gigaj0ule/safebridge/README.md

# safebridge

current limited h bridge

contains 3 modules

half bride module (2x)

electronic fuse (1x)
