gigaj0ule/safebridge/rmp_efuse_2/Schematic (PDF)/EFUSE 2.0.0.pdf

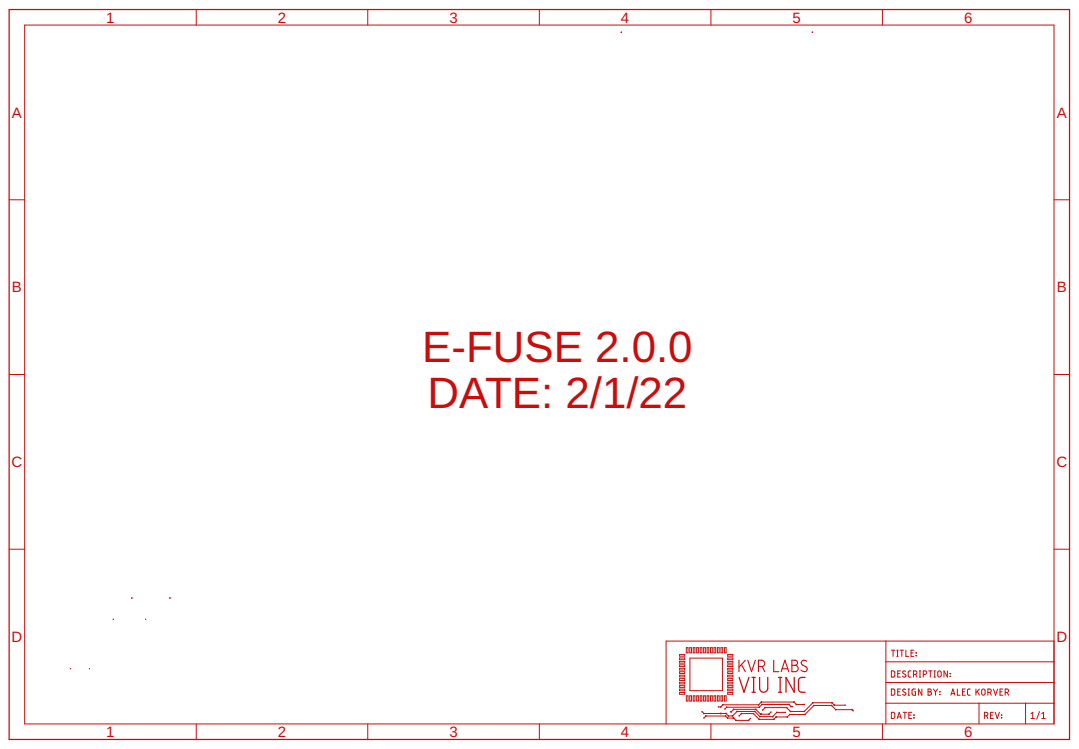
[picture p1: page 1]

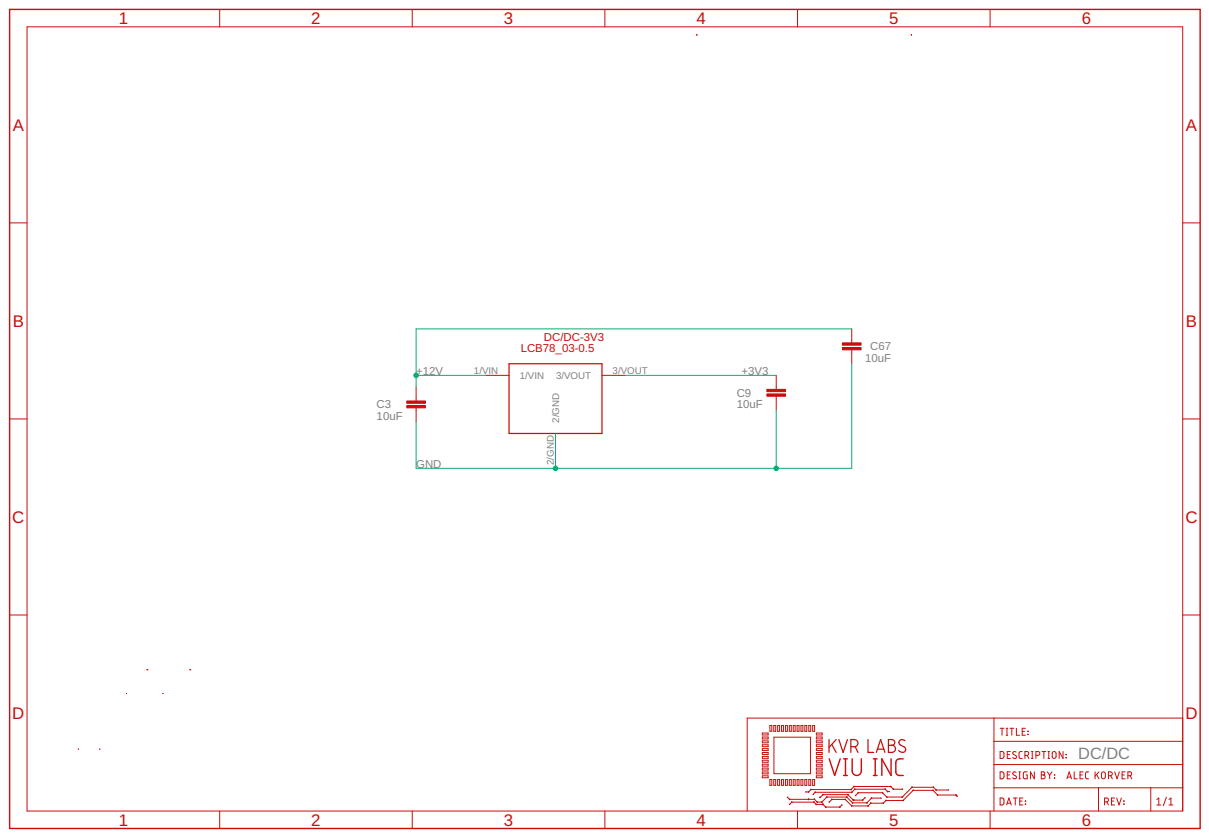
[picture p2: page 2]

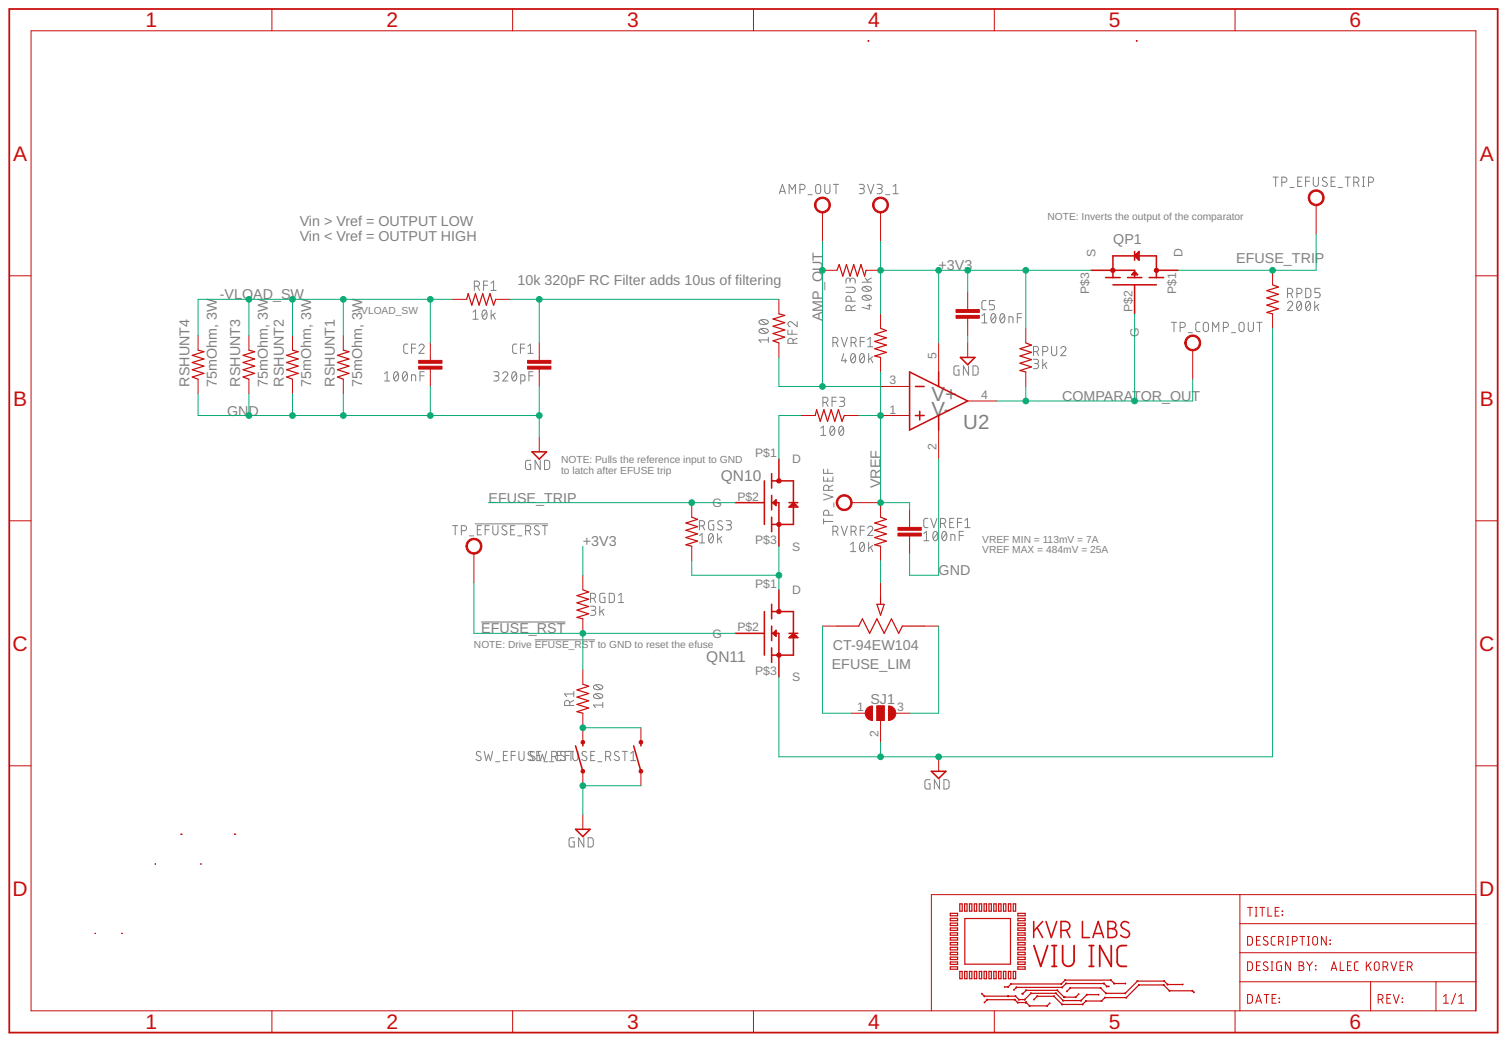
[picture p3: page 3]

Vin > Vref = OUTPUT LOW
Vin < Vref = OUTPUT HIGH

NOTE: Inverts the output of the comparator

10k 320pF RC Filter adds 10us of filtering

NOTE: Pulls the reference input to GND
to latch after EFUSE trip

EFUSE_RST
NOTE: Drive EFUSE_RST to GND to reset the efuse

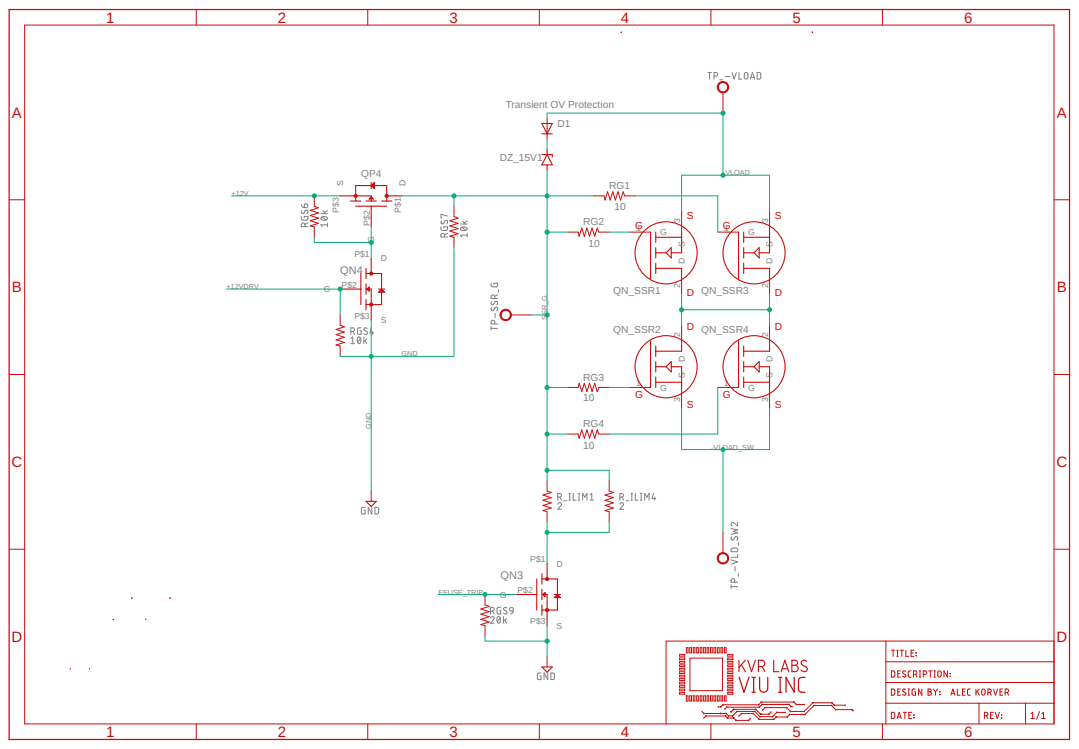
[picture p4: page 4]
