gigaj0ule/safebridge/rmp_fbps_mobo_1/Schematic (PDF)/RMP - FBPS MOBO 0.0.1.pdf

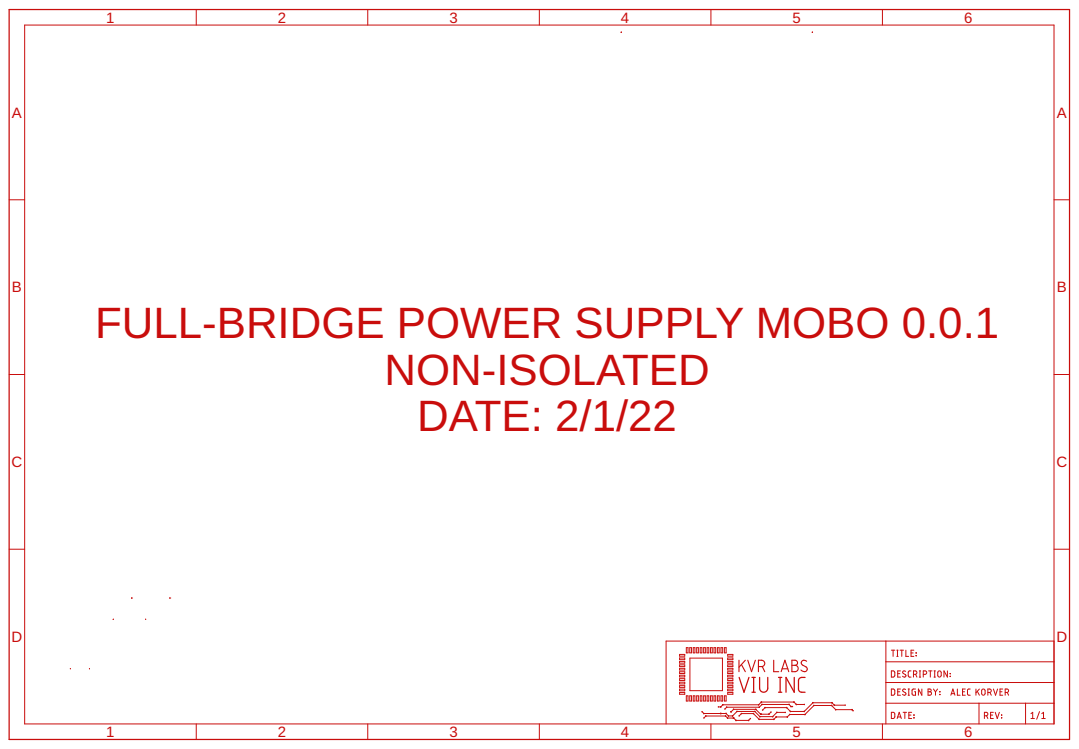
[picture p5: page 1]

FULL-BRIDGE POWER SUPPLY MOBO 0.0.1

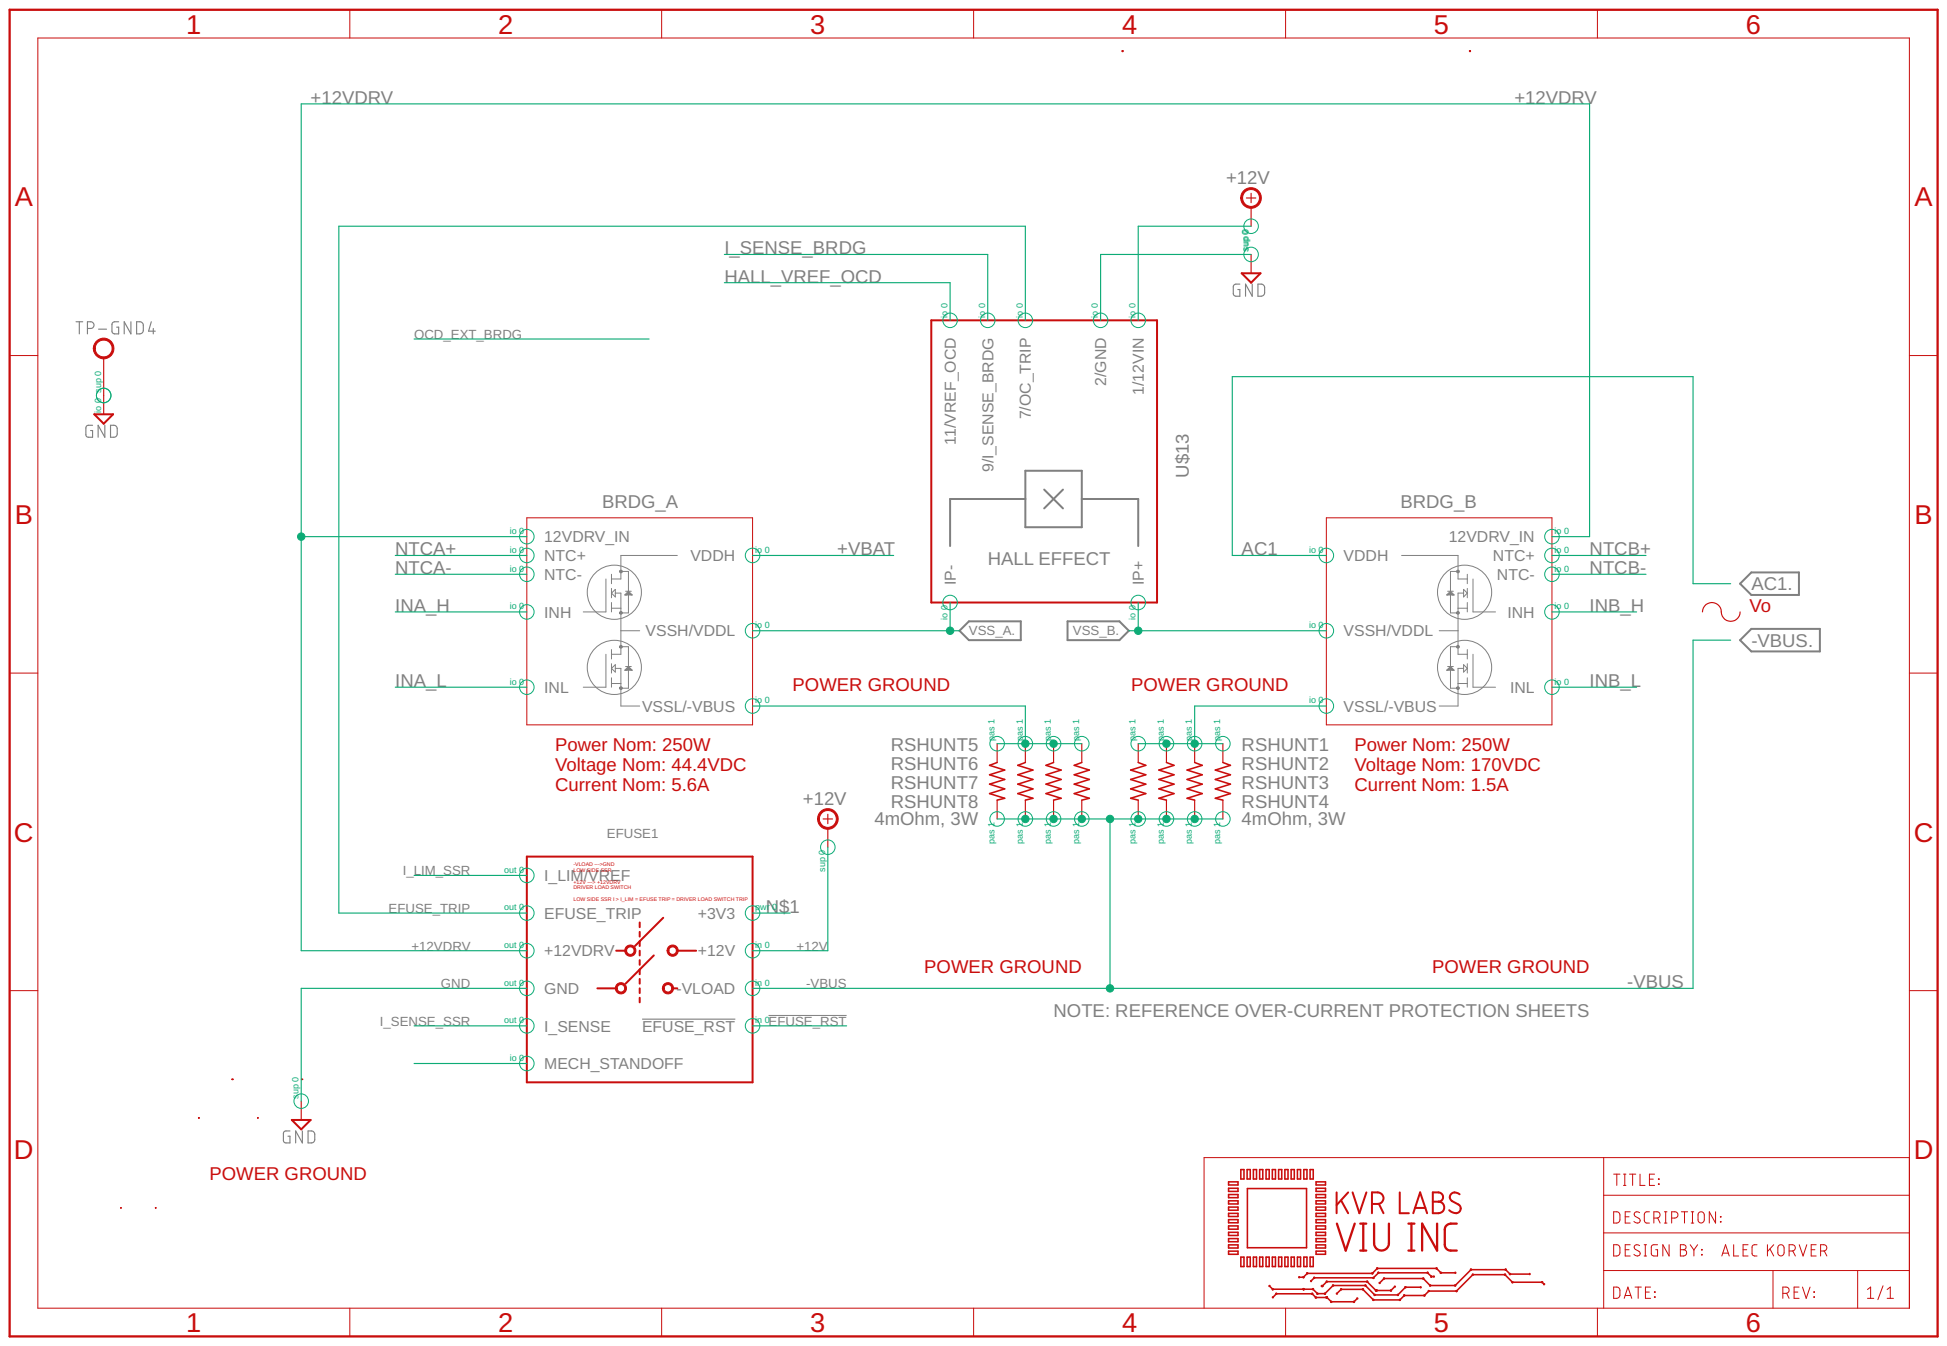
[picture p6: page 2]

LOW SIDE SSR I > I_LIM = EFUSE TRIP = DRIVER LOAD SWITCH TRIP

NOTE: REFERENCE OVER-CURRENT PROTECTION SHEETS

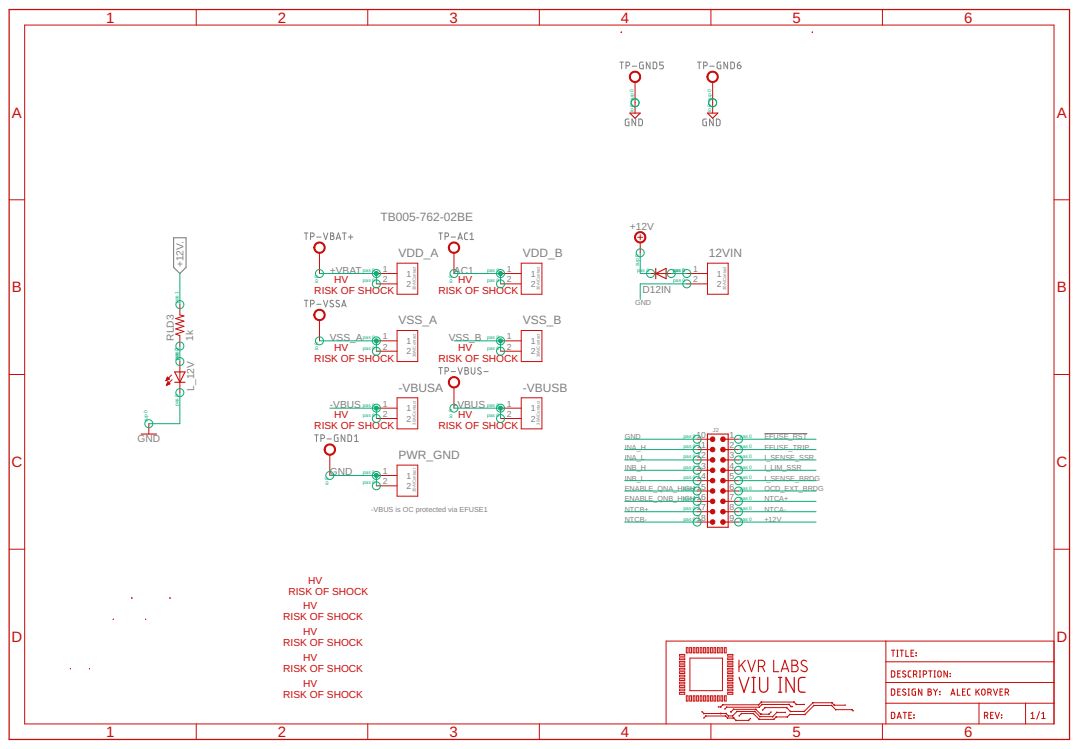
[picture p7: page 3]

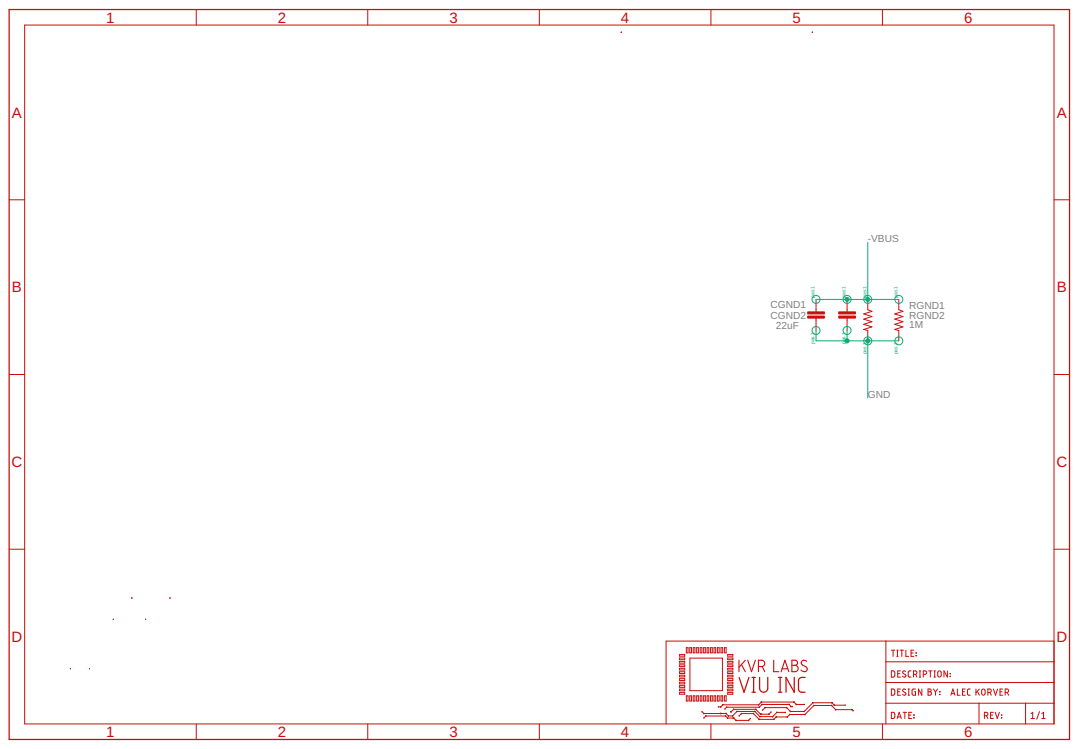
[picture p8: page 4]
