gigaj0ule/safebridge/rmp_half_bridge_1/Schematic (PDF)/RMP - HALF BRIDGE 0.0.1.pdf

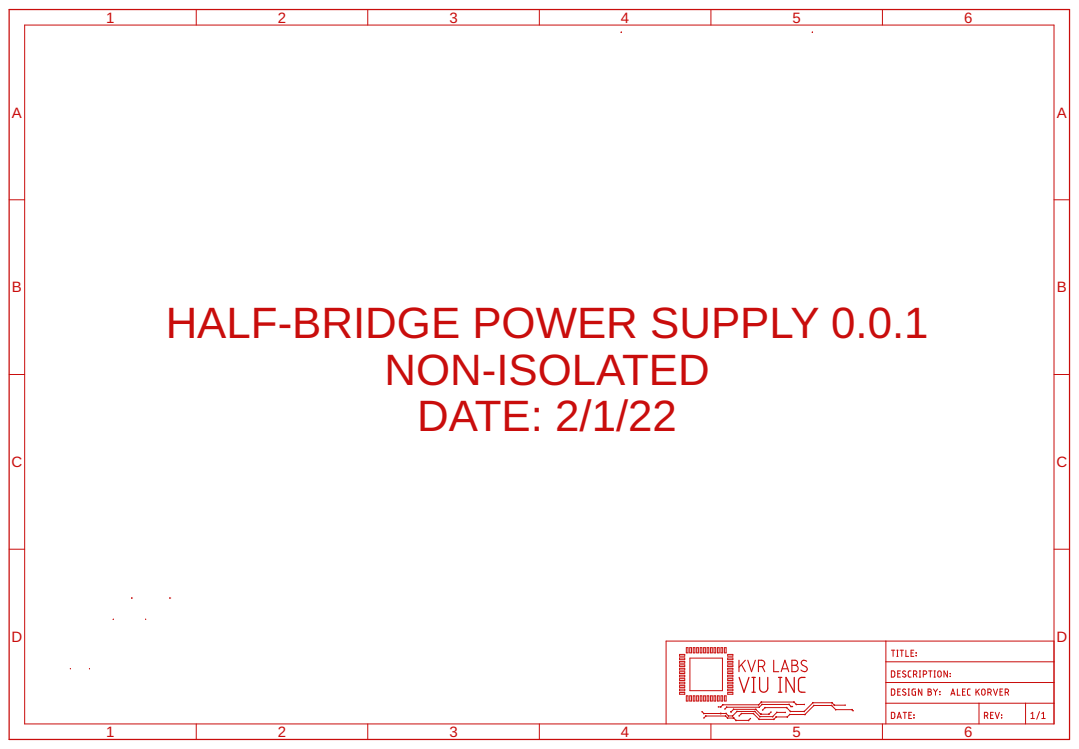
[picture p9: page 1]

HALF-BRIDGE POWER SUPPLY 0.0.1

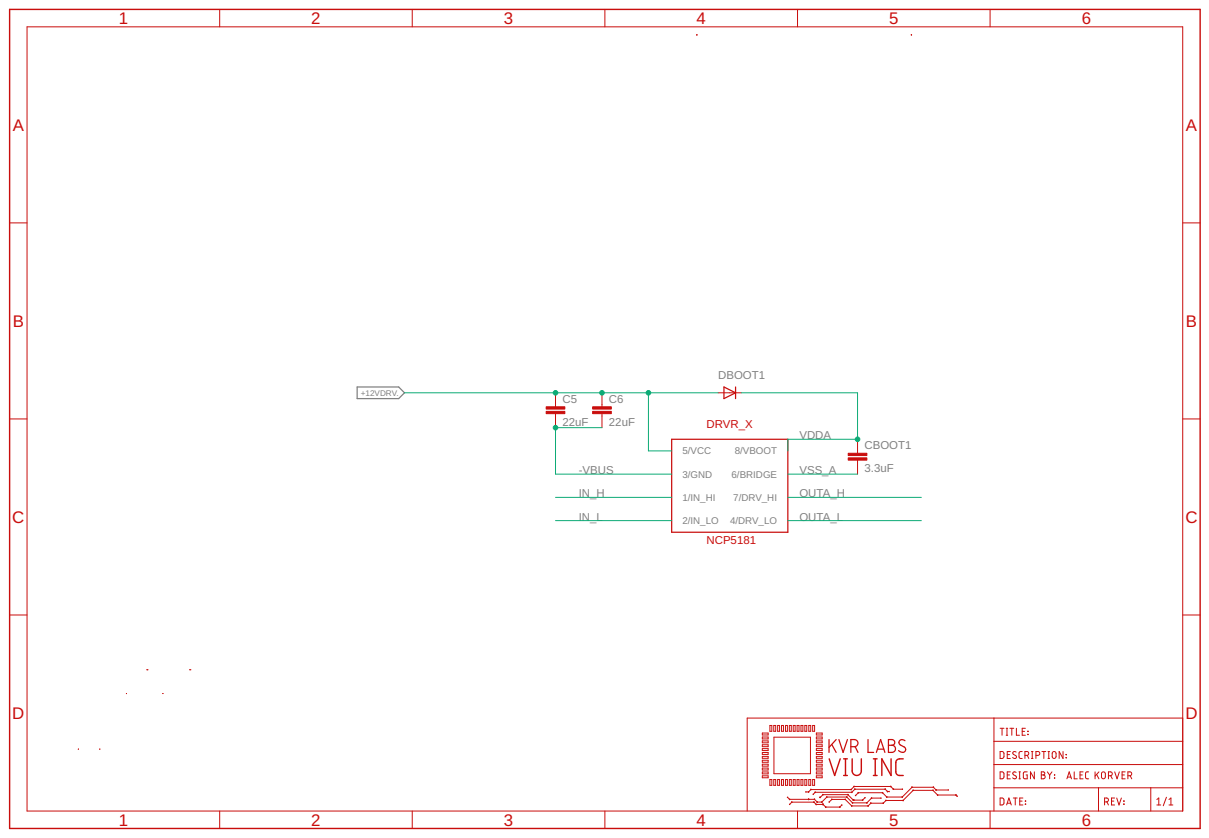
[picture p10: page 2]

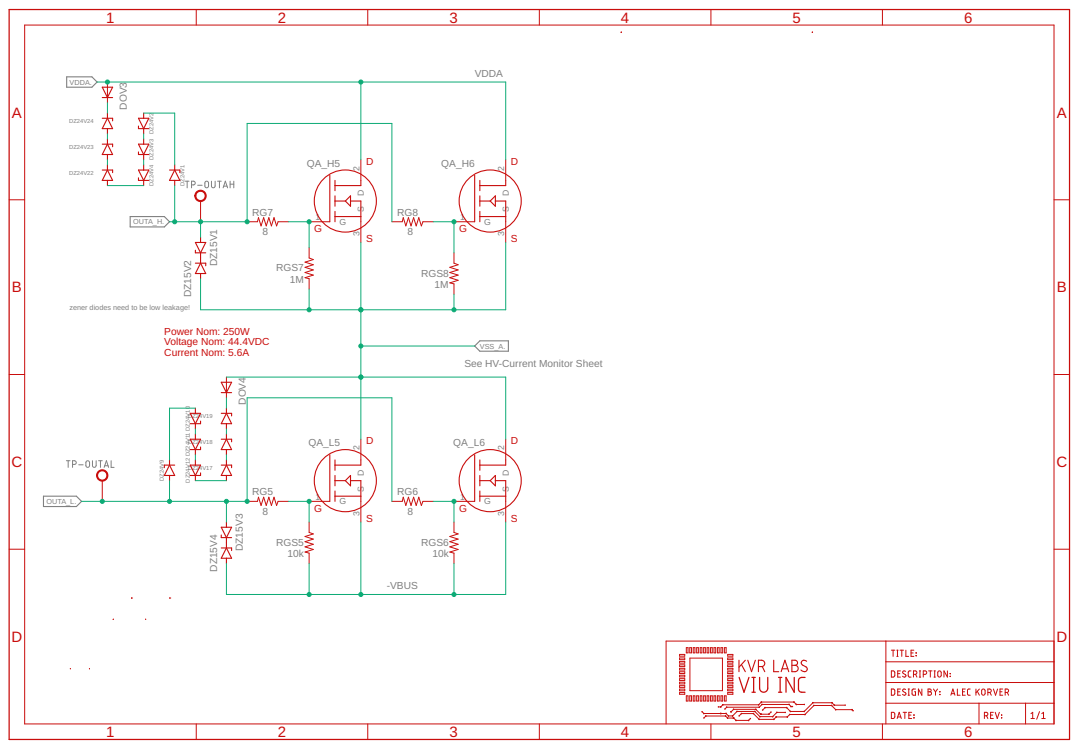
[picture p11: page 3]

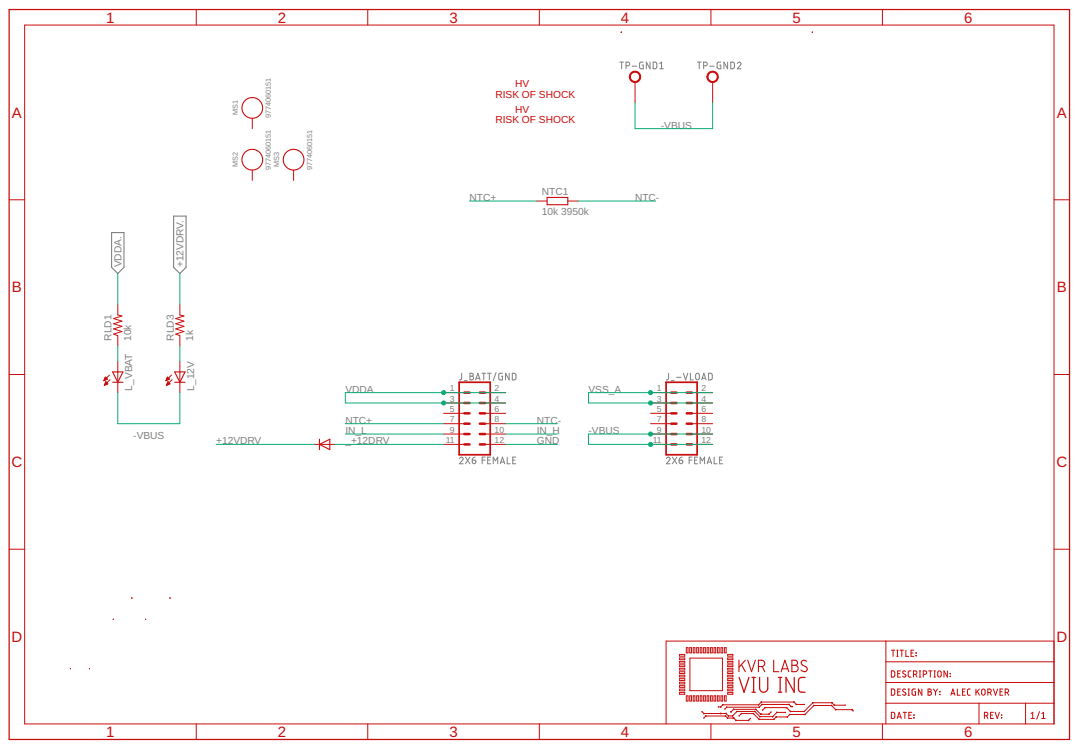
[picture p12: page 4]

10k 1k 10k 3950k RLD1 RLD3 L_VBAT L_12V 108642 9753111 12 108642 9753111 12 NTC1 MS1 9774060151 MS2 9774060151 MS3 9774060151 VDDA. VDDA VSS_A -VBUS -VBUS -VBUS GND IN_L IN_H _+12DRV +12VDRV. +12VDRV NTC+ NTC+ NTC- NTC- ABCD 1 2 3 4 5 6 ABCD 1 2 3 4 5 6 HV RISK OF SHOCK HV RISK OF SHOCK
