gigaj0ule/safebridge/rmp_fbps_mobo_1/Eagle/RMP - FBPS MOBO 0.0.1.brd

## EAGLE design rmp_fbps_mobo_1/Eagle/RMP - FBPS MOBO 0.0.1.brd (2022-04-21)

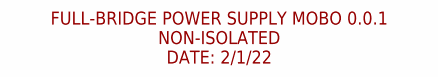
[picture p13: schematic RMP - FBPS MOBO 0.0.1.sch, sheet 1]

Notes on the sheet:
FULL-BRIDGE POWER SUPPLY MOBO 0.0.1 NON-ISOLATED DATE: 2/1/22

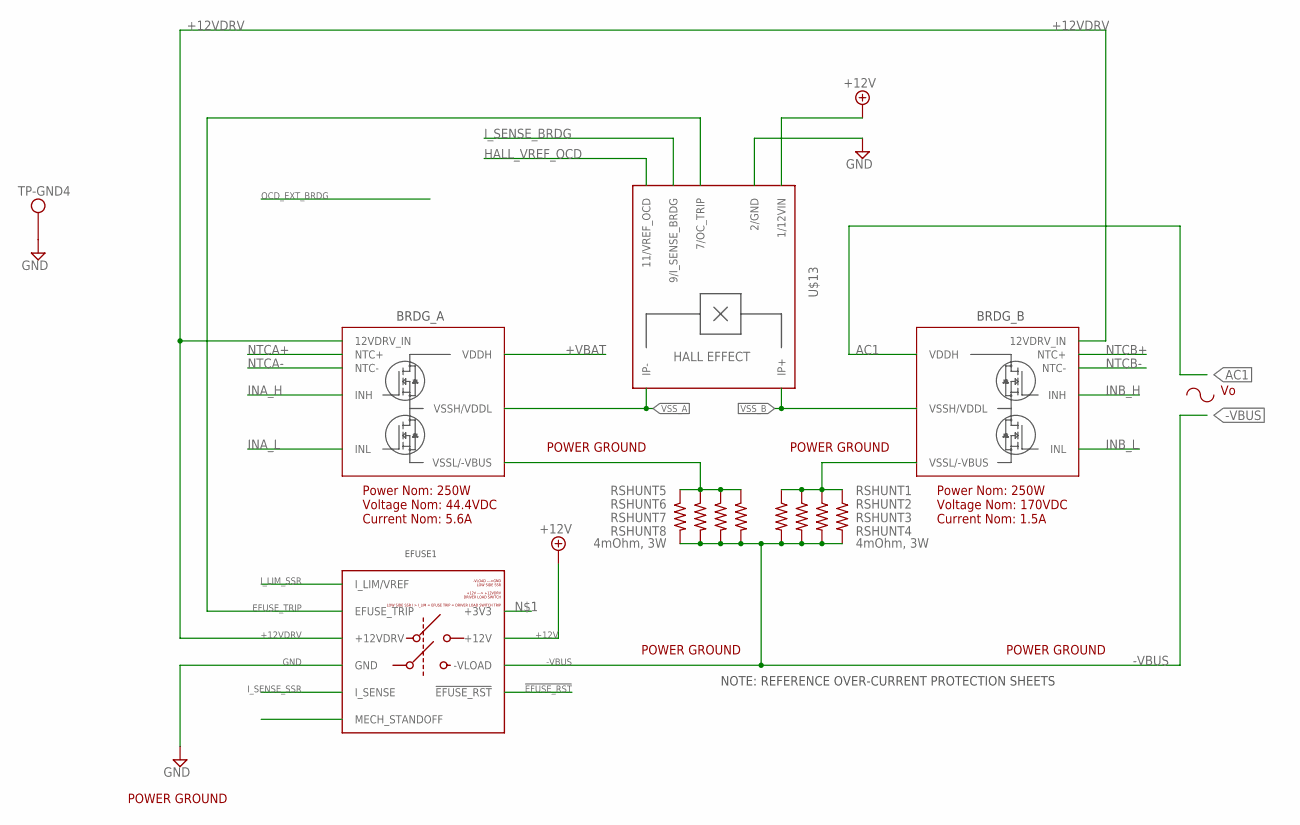
[picture p14: schematic RMP - FBPS MOBO 0.0.1.sch, sheet 2, H BRIDGE - AC/DC STAGE]

Parts:
BRDG_A: 1/2BRIDGE; LCSC_PART DNP/CUSTOM
BRDG_B: 1/2BRIDGE; LCSC_PART DNP/CUSTOM
EFUSE1: EFUSE_2.0.0; LCSC_PART DNP/CUSTOM
RSHUNT1, RSHUNT2, RSHUNT3, RSHUNT4, RSHUNT5, RSHUNT6, RSHUNT7, RSHUNT8: 4mOhm, 3W; R2512; LCSC_PART C728322
TP-GND4: THM_TESTPOINT_5000_SERIES; THM-TESTPOINT; LCSC_PART DNP
U$13: HALL_EFFECT_CURRENT_MONITOR; HALL_CURRENT_MONITOR; LCSC_PART DNP/CUSTOM

Connections:
!EFUSE_RST: EFUSE1.12/!EFUSE_RST (!EFUSE_RST); also elsewhere on the board
+12V: EFUSE1.11/12VIN (+12V), U$13.1/+12VIN (1/12VIN); also elsewhere on the board
+12VDRV: BRDG_A.11/+12DRVR (12VDRV_IN), BRDG_B.11/+12DRVR (12VDRV_IN), EFUSE1.12/12VDRV (+12VDRV)
+VBAT: BRDG_A.1/VDDA (VDDH), BRDG_A.2/VDDA (VDDH), BRDG_A.3/VDDA (VDDH), BRDG_A.4/VDDA (VDDH); also elsewhere on the board
-VBUS: EFUSE1.1/-VLOAD (-VLOAD), EFUSE1.2/-VLOAD (-VLOAD), EFUSE1.3/-VLOAD (-VLOAD), EFUSE1.4/-VLOAD (-VLOAD), EFUSE1.5/-VLOAD (-VLOAD), EFUSE1.6/-VLOAD (-VLOAD), EFUSE1.7/-VLOAD (-VLOAD), EFUSE1.8/-VLOAD (-VLOAD), RSHUNT1.2, RSHUNT2.2, RSHUNT3.2, RSHUNT4.2, RSHUNT5.2, RSHUNT6.2, RSHUNT7.2, RSHUNT8.2; also elsewhere on the board
AC1: BRDG_B.1/VDDA (VDDH), BRDG_B.2/VDDA (VDDH), BRDG_B.3/VDDA (VDDH), BRDG_B.4/VDDA (VDDH); also elsewhere on the board
EFUSE_TRIP: EFUSE1.10/EFUSE_TRIP (EFUSE_TRIP), U$13.7/EFUSE_TRIP (7/OC_TRIP); also elsewhere on the board
GND: EFUSE1.1/GND (GND), EFUSE1.2/GND (GND), EFUSE1.3/GND (GND), EFUSE1.4/GND (GND), EFUSE1.5/GND (GND), EFUSE1.6/GND (GND), EFUSE1.7/GND (GND), EFUSE1.8/GND (GND), EFUSE1.9/GND (GND), TP-GND4.P1, U$13.2/GND, U$13.3/GND (2/GND); also elsewhere on the board
HALL_VREF_OCD: U$13.11/VREF_OCD
INA_H: BRDG_A.10/IN_H (INH); also elsewhere on the board
INA_L: BRDG_A.9/IN_L (INL); also elsewhere on the board
INB_H: BRDG_B.10/IN_H (INH); also elsewhere on the board
INB_L: BRDG_B.9/IN_L (INL); also elsewhere on the board
I_LIM_SSR: EFUSE1.11/VREF (I_LIM/VREF); also elsewhere on the board
I_SENSE_BRDG: U$13.9/I_SENSE_BRDG; also elsewhere on the board
I_SENSE_SSR: EFUSE1.9/-VLOAD_SW (I_SENSE); also elsewhere on the board
unnamed: BRDG_A.9/-VBUS (VSSL/-VBUS), BRDG_A.10/-VBUS (VSSL/-VBUS), BRDG_A.11/-VBUS (VSSL/-VBUS), BRDG_A.12/-VBUS (VSSL/-VBUS), RSHUNT5.1, RSHUNT6.1, RSHUNT7.1, RSHUNT8.1
unnamed: BRDG_B.9/-VBUS (VSSL/-VBUS), BRDG_B.10/-VBUS (VSSL/-VBUS), BRDG_B.11/-VBUS (VSSL/-VBUS), BRDG_B.12/-VBUS (VSSL/-VBUS), RSHUNT1.1, RSHUNT2.1, RSHUNT3.1, RSHUNT4.1
unnamed: EFUSE1.S1 (MECH_STANDOFF), EFUSE1.S2 (MECH_STANDOFF)
NTCA+: BRDG_A.7/NTC+ (NTC+); also elsewhere on the board
NTCA-: BRDG_A.8/NTC- (NTC-); also elsewhere on the board
NTCB+: BRDG_B.7/NTC+ (NTC+); also elsewhere on the board
NTCB-: BRDG_B.8/NTC- (NTC-); also elsewhere on the board
VSS_A: BRDG_A.1/VSSA (VSSH/VDDL), BRDG_A.2/VSSA (VSSH/VDDL), BRDG_A.3/VSSA (VSSH/VDDL), BRDG_A.4/VSSA (VSSH/VDDL), U$13.7/IP- (IP-), U$13.8/IP- (IP-), U$13.9/IP- (IP-), U$13.10/IP- (IP-), U$13.11/IP- (IP-), U$13.12/IP- (IP-); also elsewhere on the board
VSS_B: BRDG_B.1/VSSA (VSSH/VDDL), BRDG_B.2/VSSA (VSSH/VDDL), BRDG_B.3/VSSA (VSSH/VDDL), BRDG_B.4/VSSA (VSSH/VDDL), U$13.1/IP+ (IP+), U$13.2/IP+ (IP+), U$13.3/IP+ (IP+), U$13.4/IP+ (IP+), U$13.5/IP+ (IP+), U$13.6/IP+ (IP+); also elsewhere on the board

Notes on the sheet:
NOTE: REFERENCE OVER-CURRENT PROTECTION SHEETS
Power Nom: 250W Voltage Nom: 170VDC Current Nom: 1.5A
Power Nom: 250W Voltage Nom: 44.4VDC Current Nom: 5.6A
POWER GROUND

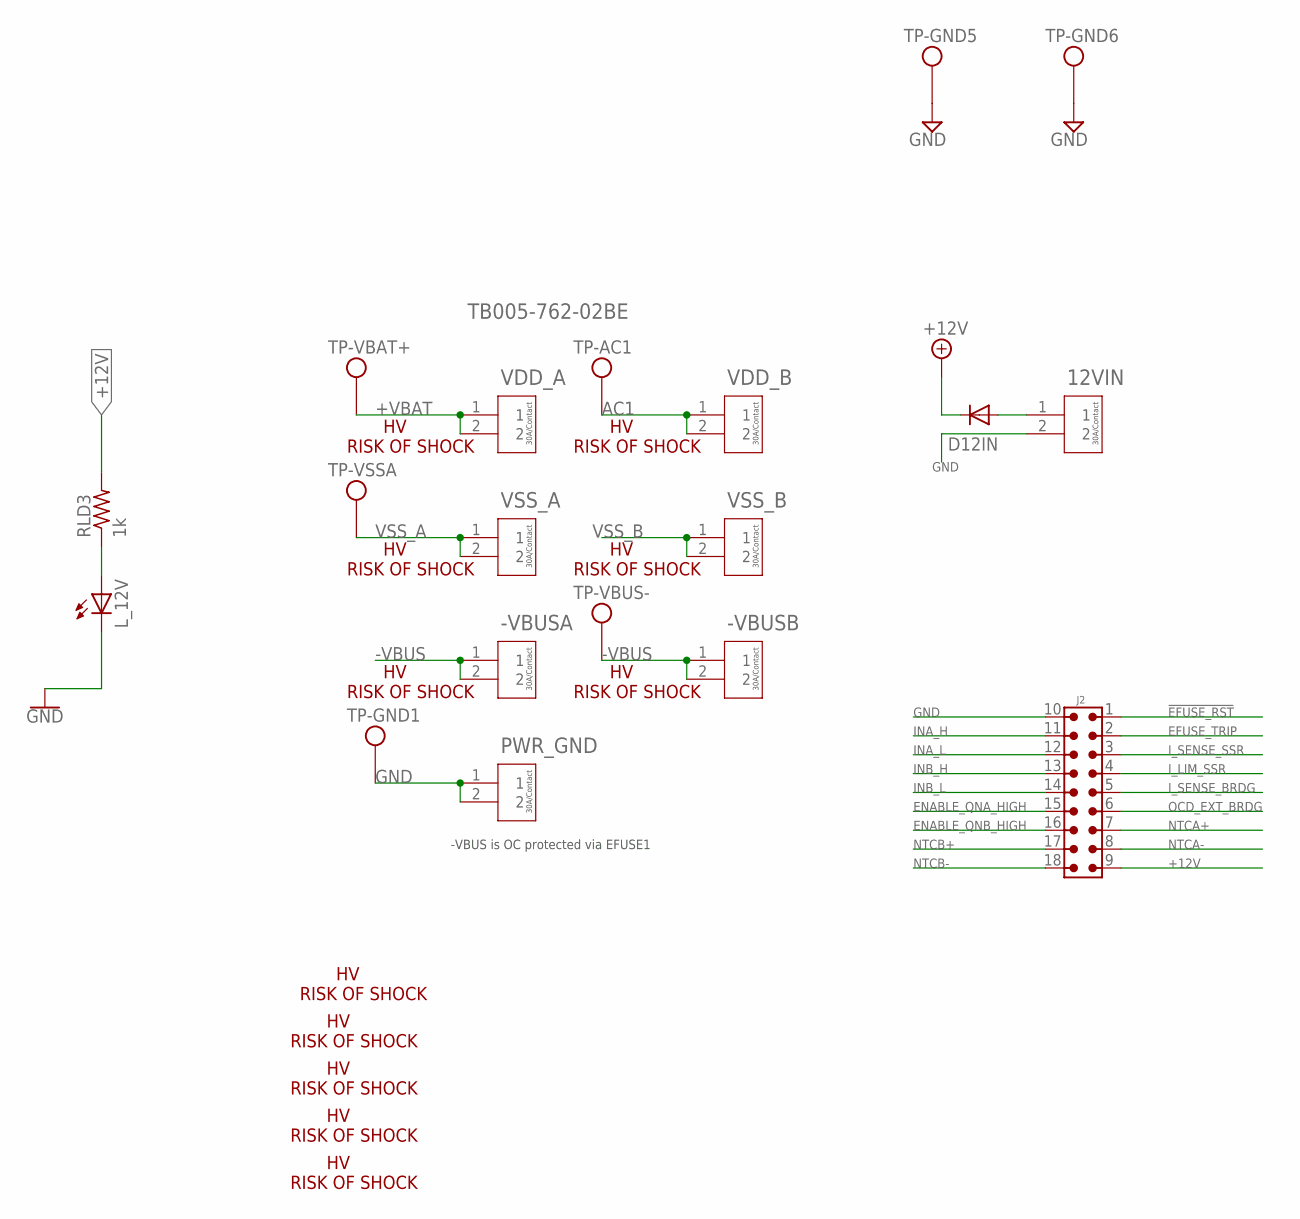
[picture p15: schematic RMP - FBPS MOBO 0.0.1.sch, sheet 3, CONNECTORS]

Parts:
12VIN: TB005-762-02BE; TB005-762-02BE_CUD; LCSC_PART DNP
-VBUSA: TB005-762-02BE; TB005-762-02BE_CUD; LCSC_PART DNP
-VBUSB: TB005-762-02BE; TB005-762-02BE_CUD; LCSC_PART DNP
D12IN: DIODESMA; SMADIODE; LCSC_PART C110531
J2: 6620XX21022_66201821022; 66201821022; LCSC_PART DNP
L_12V: LEDCHIPLED_1206; CHIPLED_1206; LCSC_PART C434439
PWR_GND: TB005-762-02BE; TB005-762-02BE_CUD; LCSC_PART DNP
RLD3: 1k; R1206; LCSC_PART C115421
TP-AC1: THM_TESTPOINT_5000_SERIES; THM-TESTPOINT; LCSC_PART DNP
TP-GND1, TP-GND5, TP-GND6: THM_TESTPOINT_5000_SERIES; THM-TESTPOINT; LCSC_PART DNP
TP-VBAT+: THM_TESTPOINT_5000_SERIES; THM-TESTPOINT; LCSC_PART DNP
TP-VBUS-: THM_TESTPOINT_5000_SERIES; THM-TESTPOINT; LCSC_PART DNP
TP-VSSA: THM_TESTPOINT_5000_SERIES; THM-TESTPOINT; LCSC_PART DNP
U$1, U$2, U$3, U$4, U$5, U$6, U$7, U$8, U$9, U$10, U$11: ELECTRIC_SHOCK; LCSC_PART DNP
VDD_A: TB005-762-02BE; TB005-762-02BE_CUD; LCSC_PART DNP
VDD_B: TB005-762-02BE; TB005-762-02BE_CUD; LCSC_PART DNP
VSS_A: TB005-762-02BE; TB005-762-02BE_CUD; LCSC_PART DNP
VSS_B: TB005-762-02BE; TB005-762-02BE_CUD; LCSC_PART DNP

Connections:
!EFUSE_RST: J2.1; also elsewhere on the board
+12V: D12IN.C, J2.9, RLD3.2; also elsewhere on the board
+VBAT: TP-VBAT+.P1, VDD_A.1, VDD_A.2; also elsewhere on the board
-VBUS: -VBUSA.1, -VBUSA.2, -VBUSB.1, -VBUSB.2, TP-VBUS-.P1; also elsewhere on the board
AC1: TP-AC1.P1, VDD_B.1, VDD_B.2; also elsewhere on the board
EFUSE_TRIP: J2.2; also elsewhere on the board
ENABLE_QNA_HIGH: J2.15
ENABLE_QNB_HIGH: J2.16
GND: 12VIN.2, J2.10, L_12V.C, PWR_GND.1, PWR_GND.2, TP-GND1.P1, TP-GND5.P1, TP-GND6.P1; also elsewhere on the board
INA_H: J2.11; also elsewhere on the board
INA_L: J2.12; also elsewhere on the board
INB_H: J2.13; also elsewhere on the board
INB_L: J2.14; also elsewhere on the board
I_LIM_SSR: J2.4; also elsewhere on the board
I_SENSE_BRDG: J2.5; also elsewhere on the board
I_SENSE_SSR: J2.3; also elsewhere on the board
unnamed: 12VIN.1, D12IN.A
unnamed: L_12V.A, RLD3.1
NTCA+: J2.7; also elsewhere on the board
NTCA-: J2.8; also elsewhere on the board
NTCB+: J2.17; also elsewhere on the board
NTCB-: J2.18; also elsewhere on the board
OCD_EXT_BRDG: J2.6
VSS_A: TP-VSSA.P1, VSS_A.1, VSS_A.2; also elsewhere on the board
VSS_B: VSS_B.1, VSS_B.2; also elsewhere on the board

Notes on the sheet:
-VBUS is OC protected via EFUSE1

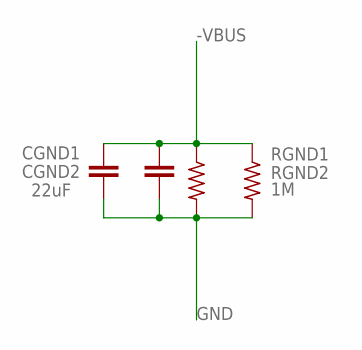
[picture p16: schematic RMP - FBPS MOBO 0.0.1.sch, sheet 4, CERAMIC DC LINK CAPACITANCE]

Parts:
CGND1, CGND2: 22uF; C1206; LCSC_PART DNP/C77091
RGND1, RGND2: 1M; R1206; LCSC_PART DNP/C26124

Connections:
-VBUS: CGND1.1, CGND2.1, RGND1.1, RGND2.1; also elsewhere on the board
GND: CGND1.2, CGND2.2, RGND1.2, RGND2.2; also elsewhere on the board

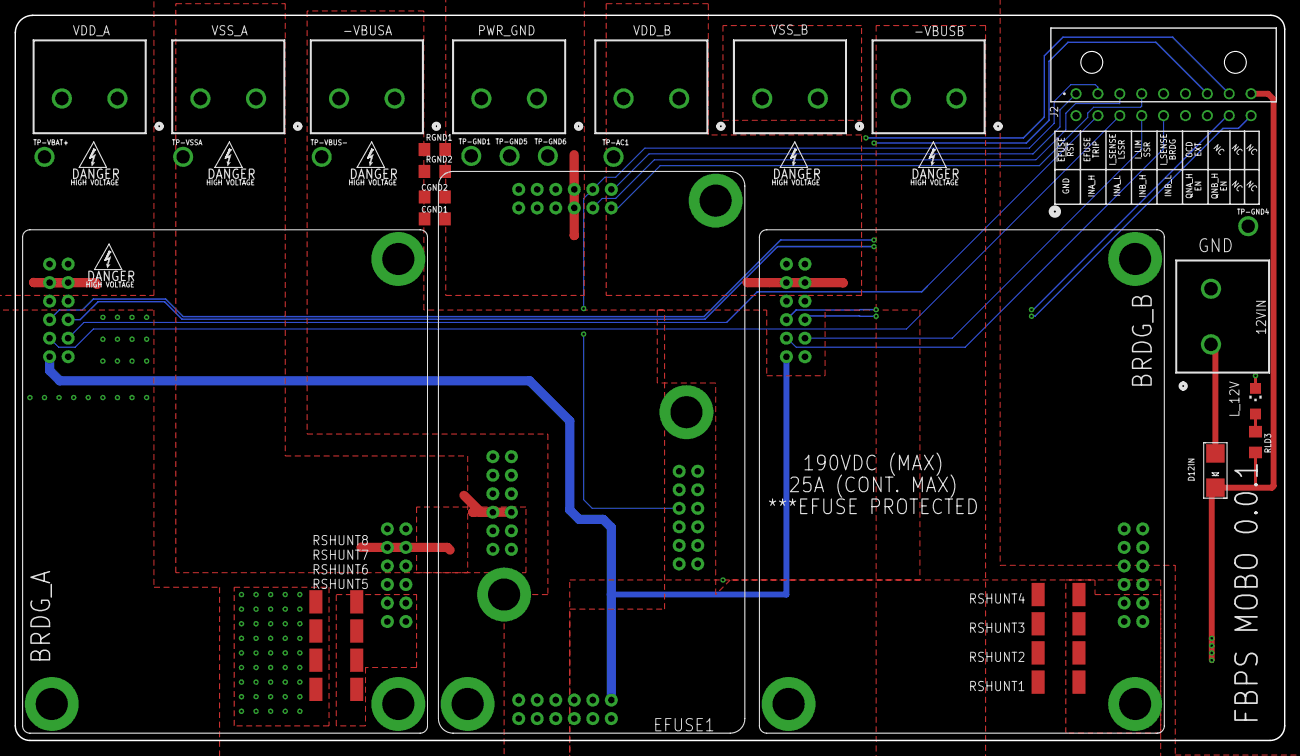
[picture p17: board RMP - FBPS MOBO 0.0.1.brd from above]

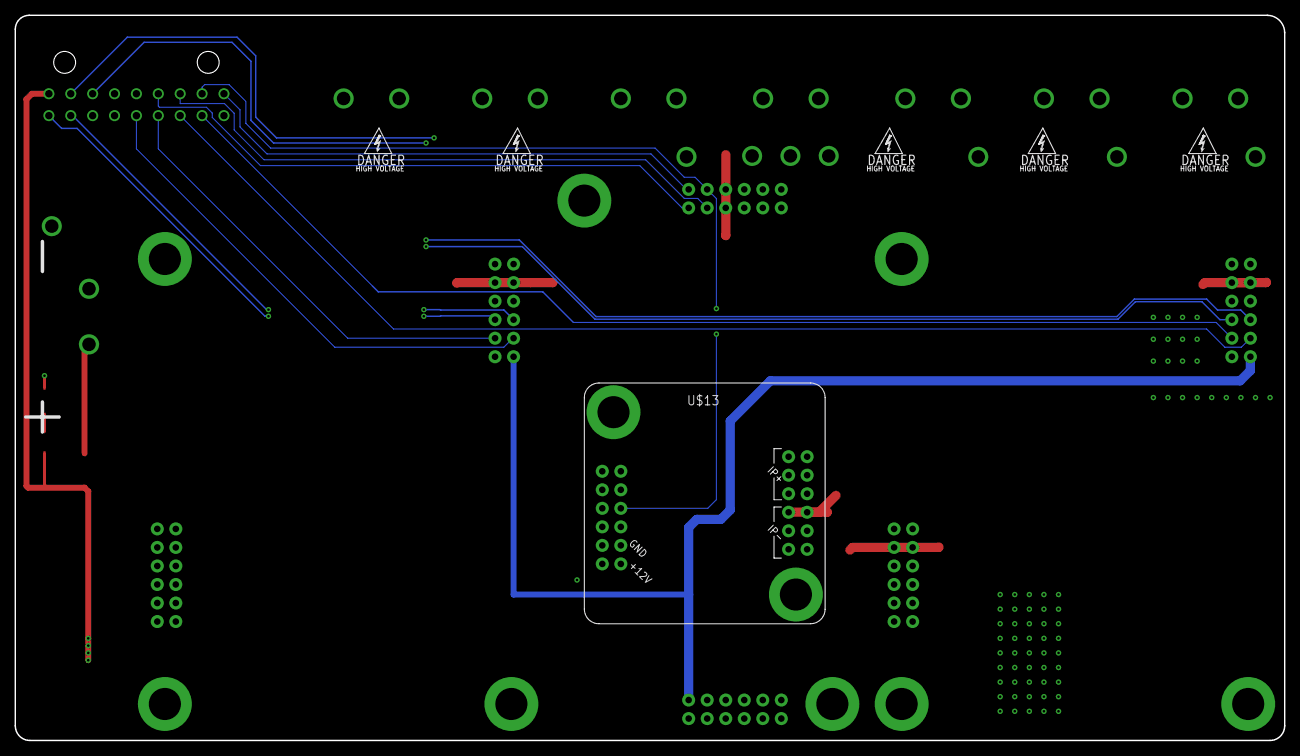
[picture p18: board RMP - FBPS MOBO 0.0.1.brd from below]

Board: 4 copper layers, 174.0 x 99.4 mm, 47 parts (6 on the bottom side), 26 nets.
