gigaj0ule/safebridge/rmp_half_bridge_1/Eagle/RMP - HALF BRIDGE 0.0.1.brd

## EAGLE design rmp_half_bridge_1/Eagle/RMP - HALF BRIDGE 0.0.1.brd (2022-04-21)

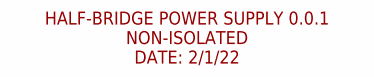
[picture p19: schematic RMP - HALF BRIDGE 0.0.1.sch, sheet 1]

Notes on the sheet:
HALF-BRIDGE POWER SUPPLY 0.0.1 NON-ISOLATED DATE: 2/1/22

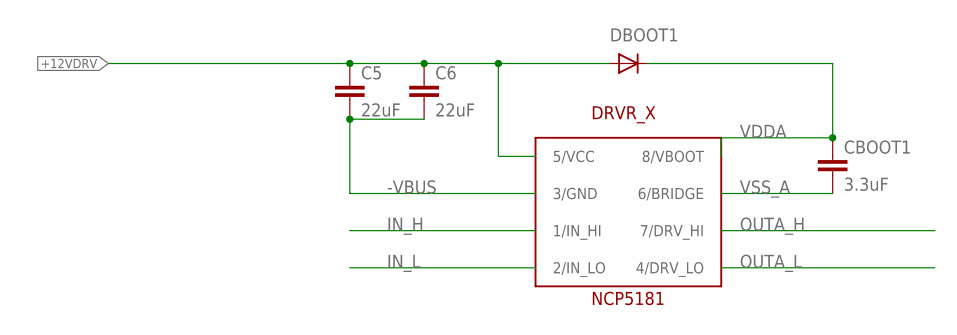
[picture p20: schematic RMP - HALF BRIDGE 0.0.1.sch, sheet 2, GATE DRIVERS]

Parts:
C5, C6: 22uF; C1206; LCSC_PART C77091
CBOOT1: 3.3uF; C1812; LCSC_PART C342636
DBOOT1: DIODESMA; SMADIODE; LCSC_PART C110531
DRVR_X: NCP5181; 8-SOIC; LCSC_PART DNP

Connections:
+12VDRV: C5.1, C6.1, DBOOT1.A, DRVR_X.5 (5/VCC); also elsewhere on the board
-VBUS: C5.2, C6.2, DRVR_X.3 (3/GND); also elsewhere on the board
IN_H: DRVR_X.1 (1/IN_HI); also elsewhere on the board
IN_L: DRVR_X.2 (2/IN_LO); also elsewhere on the board
OUTA_H: DRVR_X.7 (7/DRV_HI); also elsewhere on the board
OUTA_L: DRVR_X.4 (4/DRV_LO); also elsewhere on the board
VDDA: CBOOT1.1, DBOOT1.C, DRVR_X.8 (8/VBOOT); also elsewhere on the board
VSS_A: CBOOT1.2, DRVR_X.6 (6/BRIDGE); also elsewhere on the board

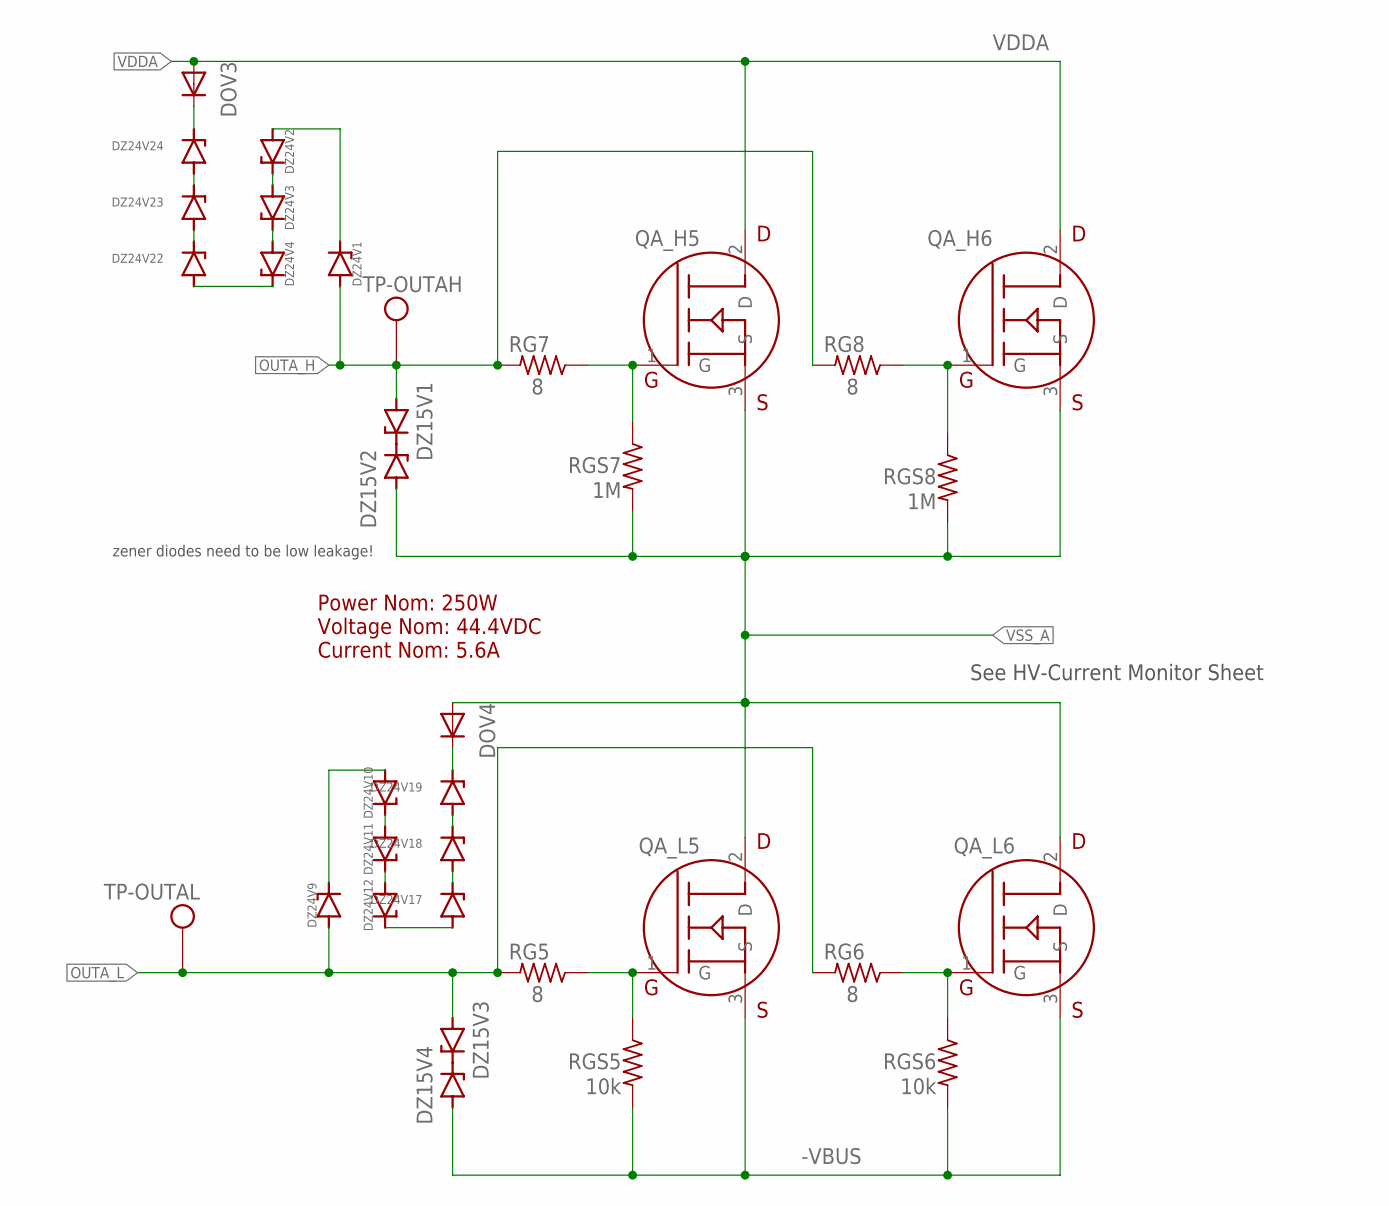
[picture p21: schematic RMP - HALF BRIDGE 0.0.1.sch, sheet 3, H BRIDGE - AC/DC STAGE]

Parts:
DOV3, DOV4: DIODESMA; SMADIODE; LCSC_PART C110531
DZ15V1, DZ15V2, DZ15V3, DZ15V4: NZH15B,115; SODFL3718X115; LCSC_PART C173428
DZ24V1, DZ24V2, DZ24V3, DZ24V4, DZ24V9, DZ24V10, DZ24V11, DZ24V12, DZ24V17, DZ24V18, DZ24V19, DZ24V22, DZ24V23, DZ24V24: NZH15B,115; SODFL3718X115; LCSC_PART C266572
QA_H5, QA_H6: IPB60R060P7ATMA1; D2PACK; LCSC_PART DNP
QA_L5, QA_L6: IPB60R060P7ATMA1; D2PACK; LCSC_PART DNP
RG5, RG6, RG7, RG8: 8; R1206; LCSC_PART C118070
RGS5, RGS6: 10k; R1206; LCSC_PART C140407
RGS7, RGS8: 1M; R1206; LCSC_PART C105578
TP-OUTAH: THM_TESTPOINT_5000_SERIES; THM-TESTPOINT; LCSC_PART DNP
TP-OUTAL: THM_TESTPOINT_5000_SERIES; THM-TESTPOINT; LCSC_PART DNP

Connections:
-VBUS: DZ15V4.2 (A), QA_L5.3 (S), QA_L6.3 (S), RGS5.2, RGS6.2; also elsewhere on the board
unnamed: DZ24V2.1 (C), DZ24V3.2 (A)
unnamed: DZ24V3.1 (C), DZ24V4.2 (A)
unnamed: DZ24V1.1 (C), DZ24V2.2 (A)
unnamed: DZ24V4.1 (C), DZ24V22.2 (A)
unnamed: DZ24V12.1 (C), DZ24V17.2 (A)
unnamed: DZ24V10.1 (C), DZ24V11.2 (A)
unnamed: DZ24V11.1 (C), DZ24V12.2 (A)
unnamed: DZ15V3.1 (C), DZ15V4.1 (C)
unnamed: DZ24V9.1 (C), DZ24V10.2 (A)
unnamed: DZ24V17.1 (C), DZ24V18.2 (A)
unnamed: DZ24V18.1 (C), DZ24V19.2 (A)
unnamed: DOV4.C, DZ24V19.1 (C)
unnamed: DZ15V1.1 (C), DZ15V2.1 (C)
unnamed: DZ24V22.1 (C), DZ24V23.2 (A)
unnamed: DZ24V23.1 (C), DZ24V24.2 (A)
unnamed: QA_L6.1 (G), RG6.1, RGS6.1
unnamed: QA_H6.1 (G), RG8.1, RGS8.1
unnamed: QA_H5.1 (G), RG7.1, RGS7.1
unnamed: QA_L5.1 (G), RG5.1, RGS5.1
unnamed: DOV3.C, DZ24V24.1 (C)
OUTA_H: DZ15V1.2 (A), DZ24V1.2 (A), RG7.2, RG8.2, TP-OUTAH.P1; also elsewhere on the board
OUTA_L: DZ15V3.2 (A), DZ24V9.2 (A), RG5.2, RG6.2, TP-OUTAL.P1; also elsewhere on the board
VDDA: DOV3.A, QA_H5.2 (D), QA_H6.2 (D); also elsewhere on the board
VSS_A: DOV4.A, DZ15V2.2 (A), QA_H5.3 (S), QA_H6.3 (S), QA_L5.2 (D), QA_L6.2 (D), RGS7.2, RGS8.2; also elsewhere on the board

Notes on the sheet:
See HV-Current Monitor Sheet
Power Nom: 250W Voltage Nom: 44.4VDC Current Nom: 5.6A
zener diodes need to be low leakage!

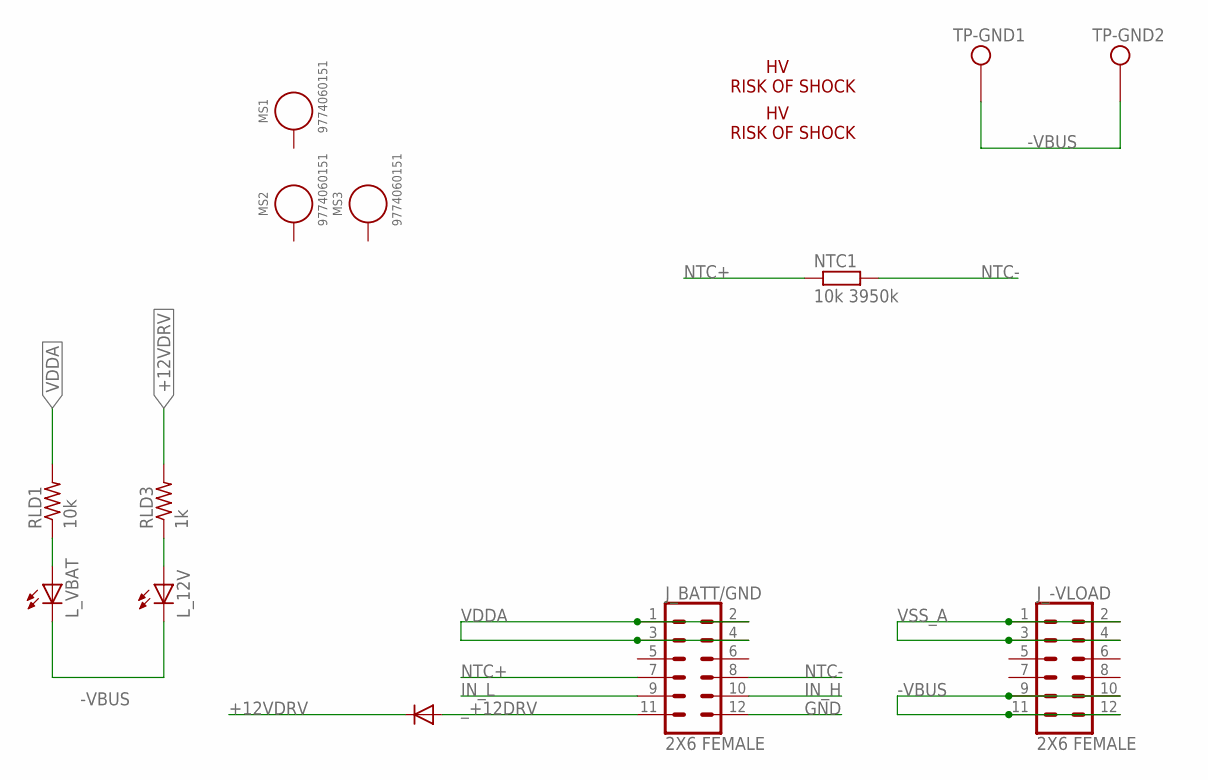
[picture p22: schematic RMP - HALF BRIDGE 0.0.1.sch, sheet 4, CONNECTORS]

Parts:
D12IN: DIODESMA; SMADIODE; LCSC_PART C110531
J_-VLOAD: 2X6 FEMALE; 2X6; LCSC_PART DNP
J_BATT/GND: 2X6 FEMALE; 2X6; LCSC_PART DNP
L_12V: LEDCHIPLED_1206; CHIPLED_1206; LCSC_PART C434439
L_VBAT: LEDCHIPLED_1206; CHIPLED_1206; LCSC_PART C434439
MS1, MS2, MS3: 9774060151; WA-SMSI_9774060151; LCSC_PART DNP
NTC1: 10k 3950k; R0805; LCSC_PART C95968
RLD1: 10k; R1206; LCSC_PART C140407
RLD3: 1k; R1206; LCSC_PART C115421
TP-GND1, TP-GND2: THM_TESTPOINT_5000_SERIES; THM-TESTPOINT; LCSC_PART DNP
U$10, U$11: ELECTRIC_SHOCK; LCSC_PART DNP

Connections:
+12VDRV: D12IN.C, RLD3.2; also elsewhere on the board
-VBUS: J_-VLOAD.9, J_-VLOAD.10, J_-VLOAD.11, J_-VLOAD.12, L_12V.C, L_VBAT.C, TP-GND1.P1, TP-GND2.P1; also elsewhere on the board
GND: J_BATT/GND.12
IN_H: J_BATT/GND.10; also elsewhere on the board
IN_L: J_BATT/GND.9; also elsewhere on the board
unnamed: L_VBAT.A, RLD1.1
unnamed: L_12V.A, RLD3.1
NTC+: J_BATT/GND.7, NTC1.1
NTC-: J_BATT/GND.8, NTC1.2
VDDA: J_BATT/GND.1, J_BATT/GND.2, J_BATT/GND.3, J_BATT/GND.4, RLD1.2; also elsewhere on the board
VSS_A: J_-VLOAD.1, J_-VLOAD.2, J_-VLOAD.3, J_-VLOAD.4; also elsewhere on the board
_+12DRV: D12IN.A, J_BATT/GND.11

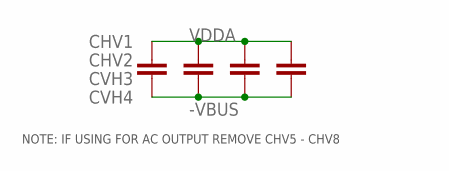
[picture p23: schematic RMP - HALF BRIDGE 0.0.1.sch, sheet 5, CERAMIC DC LINK CAPACITANCE]

Parts:
CHV1, CHV2: 3.3uF, 100V; C2220K; LCSC_PART C342270
CVH3, CVH4: 3.3uF, 100V; C2220K; LCSC_PART C342270

Connections:
-VBUS: CHV1.2, CHV2.2, CVH3.2, CVH4.2; also elsewhere on the board
VDDA: CHV1.1, CHV2.1, CVH3.1, CVH4.1; also elsewhere on the board

Notes on the sheet:
NOTE: IF USING FOR AC OUTPUT REMOVE CHV5 - CHV8

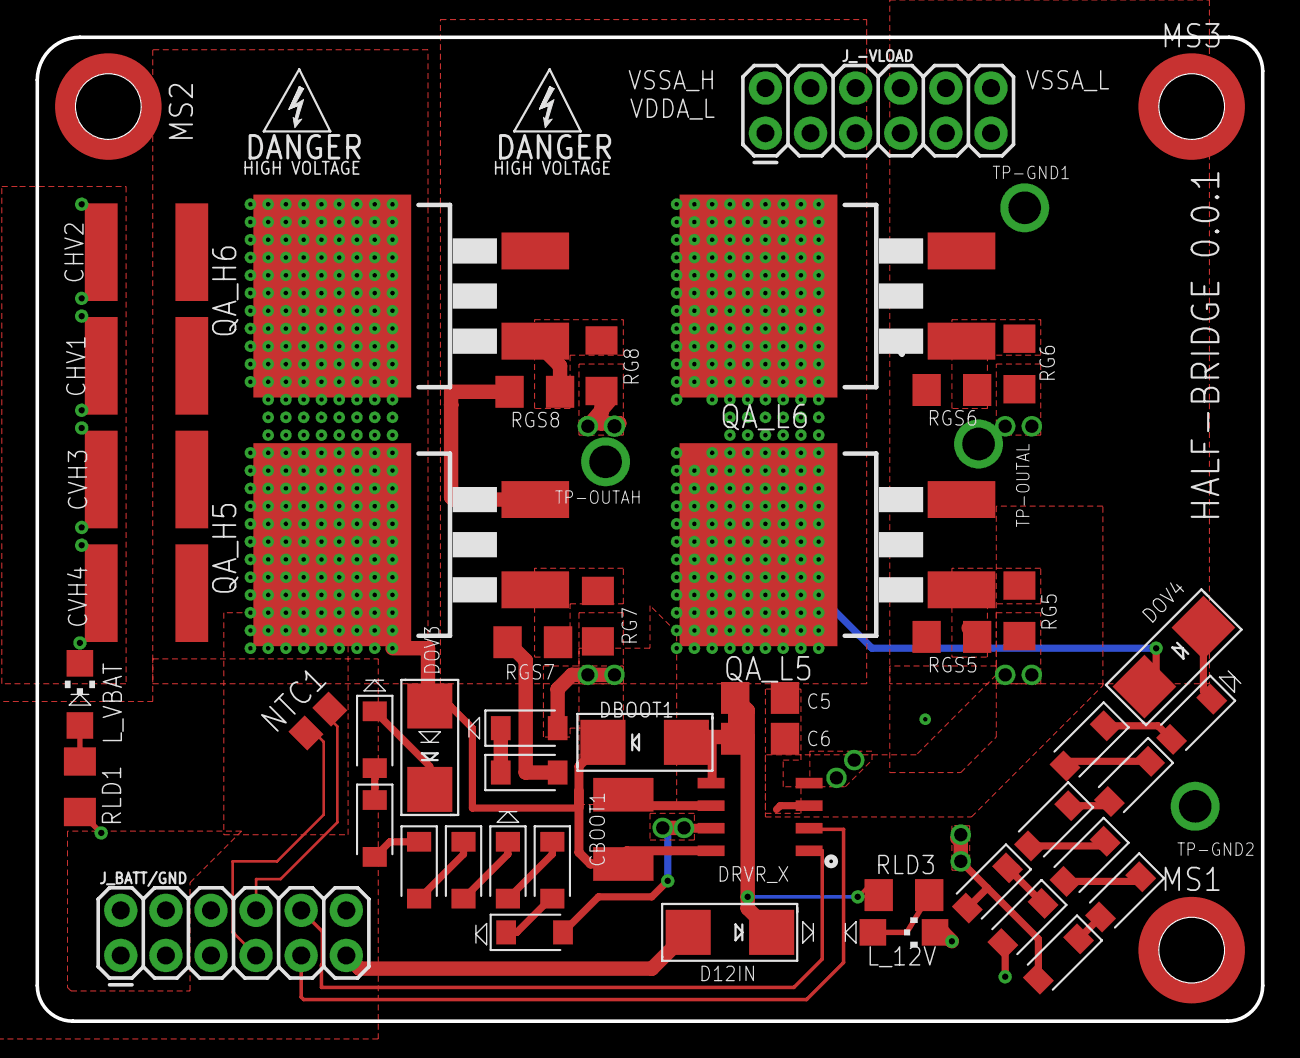
[picture p24: board RMP - HALF BRIDGE 0.0.1.brd from above]

Board: 4 copper layers, 69.0 x 55.4 mm, 58 parts (0 on the bottom side), 33 nets.
