gigaj0ule/safebridge/rmp_efuse_2/Eagle/EFUSE 2.0.0.brd

## EAGLE design rmp_efuse_2/Eagle/EFUSE 2.0.0.brd (2022-04-21)

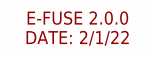
[picture p25: schematic EFUSE 2.0.0.sch, sheet 1]

Notes on the sheet:
E-FUSE 2.0.0 DATE: 2/1/22

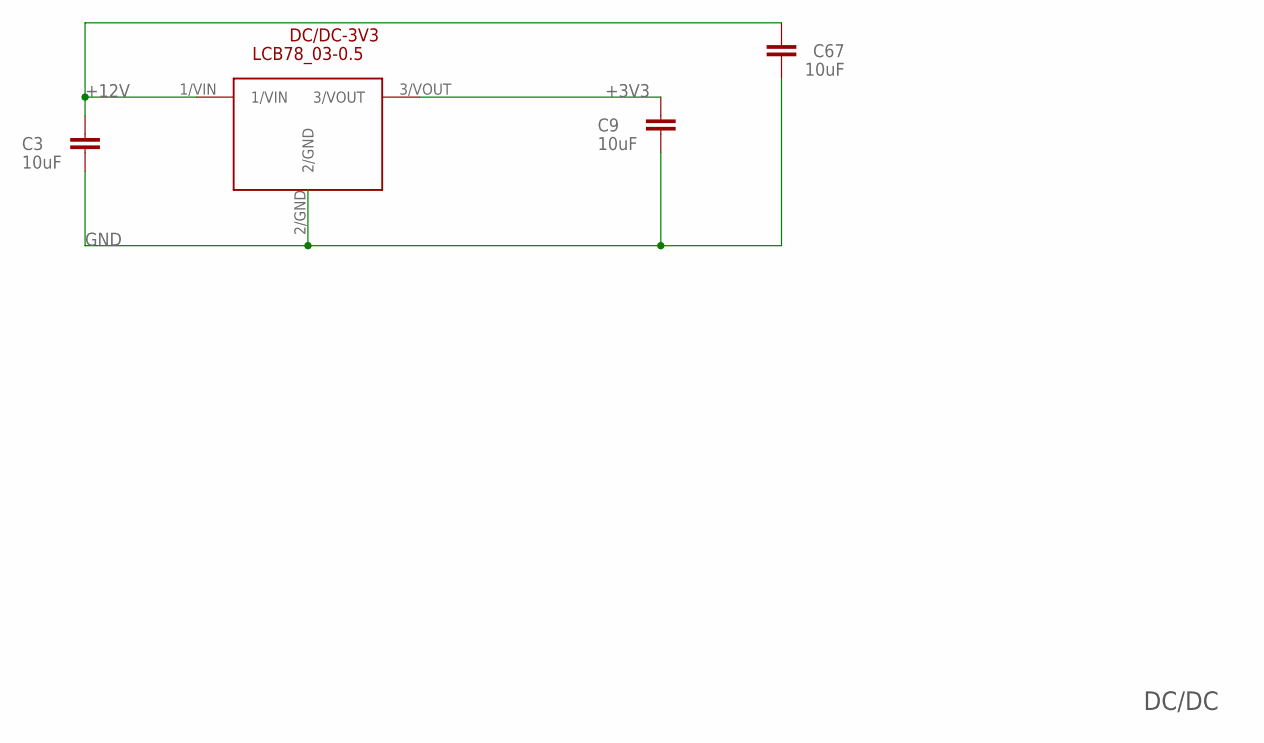
[picture p26: schematic EFUSE 2.0.0.sch, sheet 2, DC/DC]

Parts:
C3, C9, C67: 10uF; C1206; LCSC_PART C13585
DC/DC-3V3: LCB78_03-0.5; 3-SIP; LCSC_PART DNP

Connections:
+3V3: C9.2, DC/DC-3V3.3/VOUT; also elsewhere on the board
+12V: C3.2, C67.2, DC/DC-3V3.1/VIN; also elsewhere on the board
GND: C3.1, C9.1, C67.1, DC/DC-3V3.2/GND; also elsewhere on the board

Notes on the sheet:
DC/DC

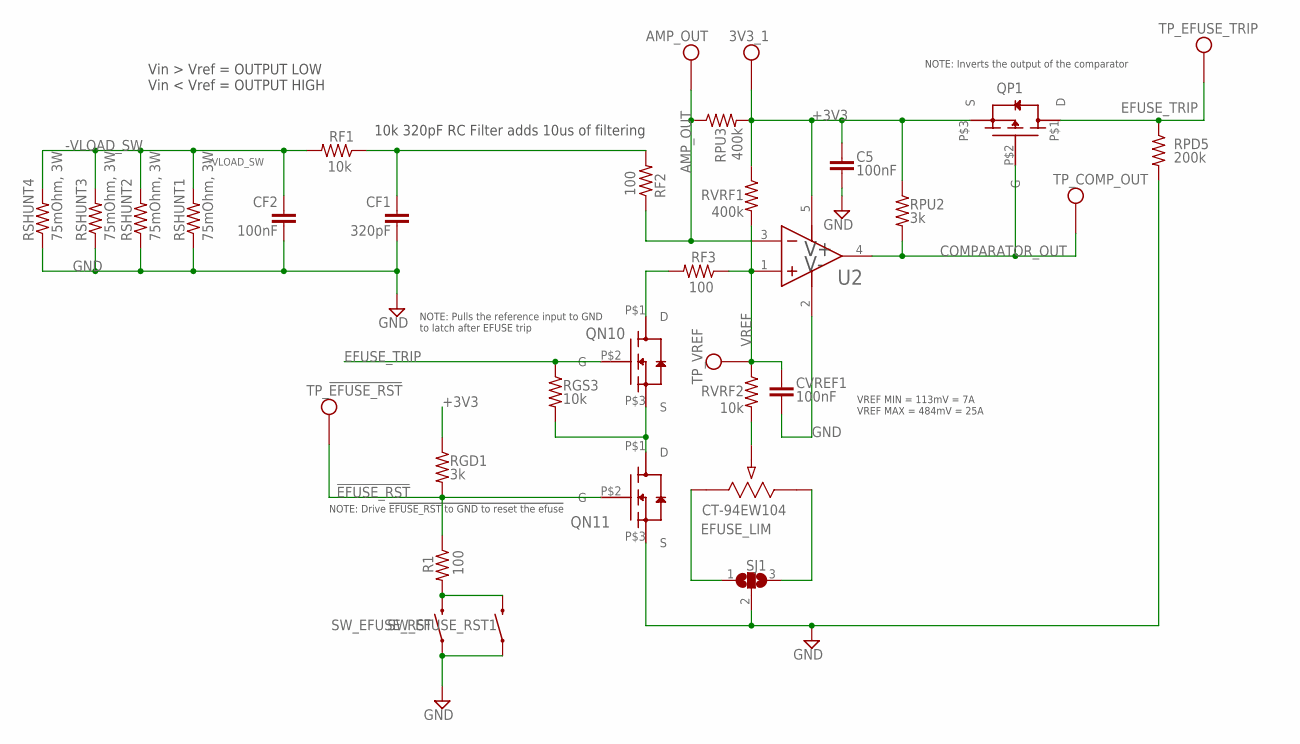
[picture p27: schematic EFUSE 2.0.0.sch, sheet 3, Over Current Protection]

Parts:
3V3_1: THM_TESTPOINT_5000_SERIES; THM-TESTPOINT
AMP_OUT: THM_TESTPOINT_5000_SERIES; THM-TESTPOINT
C5: 100nF; C0603; LCSC_PART C14663
CF1: 320pF; C0603; LCSC_PART C14663
CF2: 100nF; C0603; LCSC_PART C14663
CVREF1: 100nF; C0603; LCSC_PART C14663
EFUSE_LIM: CT-94EW104; POT_CT-94EW_NDC; LCSC_PART DNP
QN10, QN11: NFET-(SOT-23-3)(TO-236-3)(SC-59); SOT23,SC-59,TO-236-3; LCSC_PART C296286
QP1: PFET-(SOT-23-3)(TO-236-3)(SC-59); SOT23,SC-59,TO-236-3; LCSC_PART C489594
R1: 100; R0603; LCSC_PART C103197
RF1: 10k; R0603; LCSC_PART C491175
RF2, RF3: 100; R0603; LCSC_PART C103197
RGD1: 3k; R0603; LCSC_PART C126358
RGS3: 10k; R0603; LCSC_PART C116677
RPD5: 200k; R0603; LCSC_PART C95331
RPU2: 3k; R0603; LCSC_PART C126358
RPU3: 400k; R0603; LCSC_PART C209133
RSHUNT1, RSHUNT2, RSHUNT3, RSHUNT4: 75mOhm, 3W; R2512; LCSC_PART C459689
RVRF1: 400k; R0603; LCSC_PART C209133
RVRF2: 10k; R0603; LCSC_PART C116677
SJ1: SJ2W; SJ_2; LCSC_PART DNP
SW_EFUSE_RST, SW_EFUSE_RST1: MOMENTARY-SWITCH-SPST-SMD-6.0X3.5MM; TACTILE_SWITCH_SMD_6.0X3.5MM; LCSC_PART C520860
TP_!EFUSE_RST: THM_TESTPOINT_5000_SERIES; THM-TESTPOINT
TP_COMP_OUT: THM_TESTPOINT_5000_SERIES; THM-TESTPOINT
TP_EFUSE_TRIP: THM_TESTPOINT_5000_SERIES; THM-TESTPOINT
TP_VREF: THM_TESTPOINT_5000_SERIES; THM-TESTPOINT
U2: LMV331M5X; MF05A; LCSC_PART C253067

Connections:
!EFUSE_RST: QN11.P$2 (G), R1.1, RGD1.2, TP_!EFUSE_RST.P1; also elsewhere on the board
+3V3: 3V3_1.P1, C5.1, QP1.P$3 (S), RGD1.1, RPU2.1, RPU3.2, RVRF1.1, U2.5 (V+); also elsewhere on the board
-VLOAD_SW: CF2.1, RF1.2, RSHUNT1.2, RSHUNT2.2, RSHUNT3.2, RSHUNT4.2; also elsewhere on the board
AMP_OUT: AMP_OUT.P1, RF2.1, RPU3.1, U2.3 (IN-)
COMPARATOR_OUT: QP1.P$2 (G), RPU2.2, TP_COMP_OUT.P1, U2.4 (OUT)
EFUSE_TRIP: QN10.P$2 (G), QP1.P$1 (D), RGS3.1, RPD5.1, TP_EFUSE_TRIP.P1; also elsewhere on the board
GND: C5.2, CF1.2, CF2.2, CVREF1.2, QN11.P$3 (S), RPD5.2, RSHUNT1.1, RSHUNT2.1, RSHUNT3.1, RSHUNT4.1, SJ1.2, SW_EFUSE_RST.1, SW_EFUSE_RST1.1, U2.2 (V-); also elsewhere on the board
unnamed: QN10.P$1 (D), RF3.2
unnamed: QN10.P$3 (S), QN11.P$1 (D), RGS3.2
unnamed: R1.2, SW_EFUSE_RST.2, SW_EFUSE_RST1.2
unnamed: EFUSE_LIM.2, RVRF2.2
unnamed: EFUSE_LIM.1, SJ1.1
unnamed: EFUSE_LIM.3, SJ1.3
VOUTB: CF1.1, RF1.1, RF2.2
VREF: CVREF1.1, RF3.1, RVRF1.2, RVRF2.1, TP_VREF.P1, U2.1 (IN+); also elsewhere on the board

Notes on the sheet:
Vin > Vref = OUTPUT LOW Vin < Vref = OUTPUT HIGH
NOTE: Pulls the reference input to GND to latch after EFUSE trip
NOTE: Inverts the output of the comparator
NOTE: Drive !EFUSE_RST to GND to reset the efuse
10k 320pF RC Filter adds 10us of filtering
VREF MIN = 113mV = 7A VREF MAX = 484mV = 25A

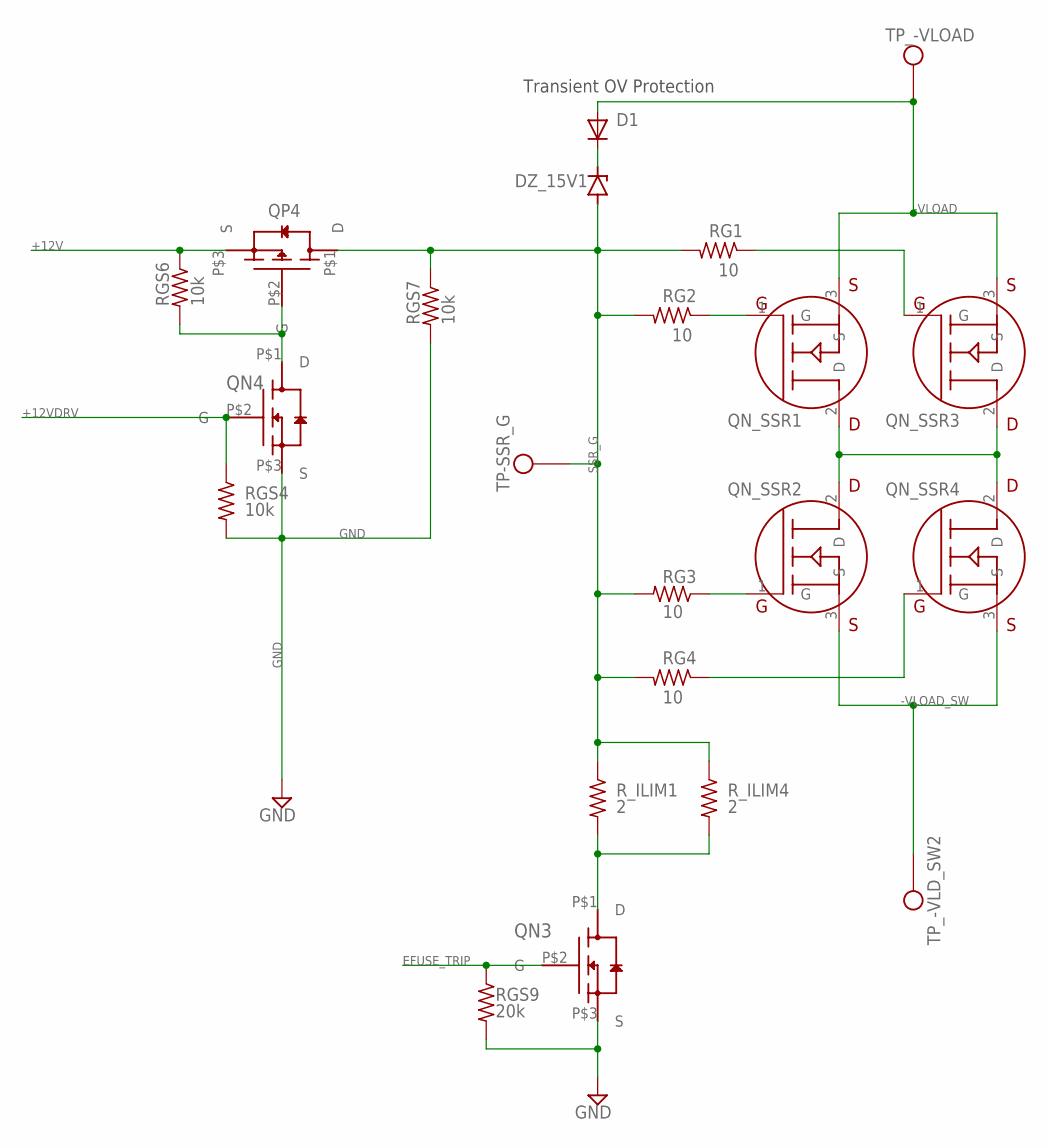
[picture p28: schematic EFUSE 2.0.0.sch, sheet 4, LOW SIDE SSR]

Parts:
D1: DIODESMA; SMADIODE; LCSC_PART C110531
DZ_15V1: NZH15B,115; SODFL3718X115; LCSC_PART C173428
QN3, QN4: NFET-(SOT-23-3)(TO-236-3)(SC-59); SOT23,SC-59,TO-236-3; LCSC_PART C296286
QN_SSR1, QN_SSR2, QN_SSR3, QN_SSR4: IPB60R060P7ATMA1; D2PACK; LCSC_PART DNP
QP4: PFET-(SOT-23-3)(TO-236-3)(SC-59); SOT23,SC-59,TO-236-3; LCSC_PART C489594
RG1, RG2, RG3, RG4: 10; R1206; LCSC_PART C326706
RGS4, RGS6, RGS7: 10k; R0603; LCSC_PART C116677
RGS9: 20k; R0603; LCSC_PART C118368
R_ILIM1, R_ILIM4: 2; R1206; LCSC_PART C102322
TP-SSR_G: THM_TESTPOINT_5000_SERIES; THM-TESTPOINT
TP_-VLD_SW2: THM_TESTPOINT_5000_SERIES; THM-TESTPOINT
TP_-VLOAD: THM_TESTPOINT_5000_SERIES; THM-TESTPOINT

Connections:
+12V: QP4.P$3 (S), RGS6.1; also elsewhere on the board
+12VDRV: QN4.P$2 (G), RGS4.1; also elsewhere on the board
-VLOAD: D1.A, QN_SSR1.3 (S), QN_SSR3.3 (S), TP_-VLOAD.P1; also elsewhere on the board
-VLOAD_SW: QN_SSR2.3 (S), QN_SSR4.3 (S), TP_-VLD_SW2.P1; also elsewhere on the board
EFUSE_TRIP: QN3.P$2 (G), RGS9.1; also elsewhere on the board
GND: QN3.P$3 (S), QN4.P$3 (S), RGS4.2, RGS7.2, RGS9.2; also elsewhere on the board
unnamed: QN4.P$1 (D), QP4.P$2 (G), RGS6.2
unnamed: D1.C, DZ_15V1.1 (C)
unnamed: QN_SSR2.1 (G), RG3.1
unnamed: QN_SSR3.1 (G), RG1.1
unnamed: QN_SSR4.1 (G), RG4.1
unnamed: QN_SSR1.1 (G), RG2.1
unnamed: QN3.P$1 (D), R_ILIM1.2, R_ILIM4.2
SSR_G: DZ_15V1.2 (A), QP4.P$1 (D), RG1.2, RG2.2, RG3.2, RG4.2, RGS7.1, R_ILIM1.1, R_ILIM4.1, TP-SSR_G.P1
VSS_A1: QN_SSR1.2 (D), QN_SSR2.2 (D), QN_SSR3.2 (D), QN_SSR4.2 (D)

Notes on the sheet:
Transient OV Protection
