gigaj0ule/safebridge/rmp_efuse_2/Eagle/EFUSE 2.0.0.brd

## EAGLE design rmp_efuse_2/Eagle/EFUSE 2.0.0.brd (continued)

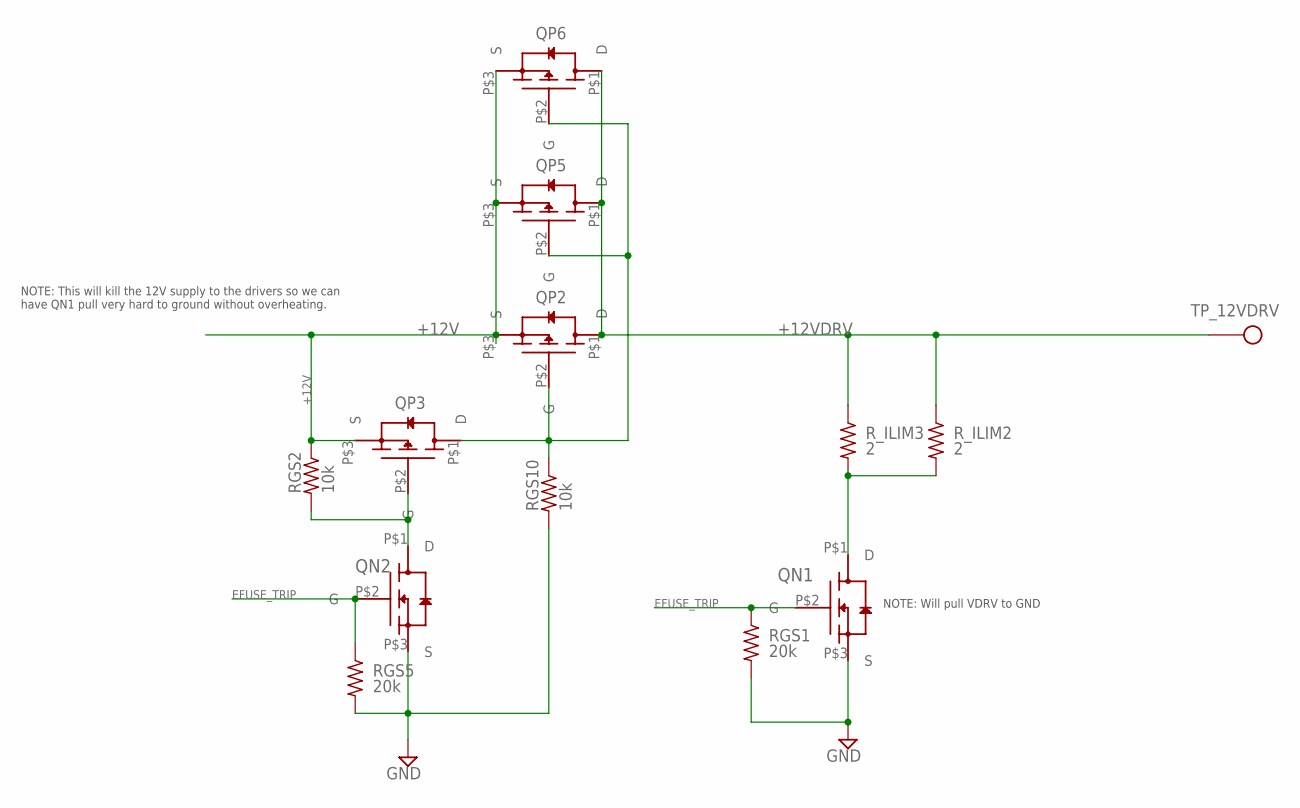
[picture p29: schematic EFUSE 2.0.0.sch, sheet 5, DRIVER LOAD SWITCH]

Parts:
QN1, QN2: NFET-(SOT-23-3)(TO-236-3)(SC-59); SOT23,SC-59,TO-236-3; LCSC_PART C296286
QP2, QP3, QP5, QP6: PFET-(SOT-23-3)(TO-236-3)(SC-59); SOT23,SC-59,TO-236-3; LCSC_PART C489594
RGS1, RGS5: 20k; R0603; LCSC_PART C118368
RGS2, RGS10: 10k; R0603; LCSC_PART C116677
R_ILIM2, R_ILIM3: 2; R1206; LCSC_PART C102322
TP_12VDRV: THM_TESTPOINT_5000_SERIES; THM-TESTPOINT

Connections:
+12V: QP2.P$3 (S), QP3.P$3 (S), QP5.P$3 (S), QP6.P$3 (S), RGS2.1; also elsewhere on the board
+12VDRV: QP2.P$1 (D), QP5.P$1 (D), QP6.P$1 (D), R_ILIM2.1, R_ILIM3.1, TP_12VDRV.P1; also elsewhere on the board
EFUSE_TRIP: QN1.P$2 (G), QN2.P$2 (G), RGS1.1, RGS5.1; also elsewhere on the board
GND: QN1.P$3 (S), QN2.P$3 (S), RGS1.2, RGS5.2, RGS10.2; also elsewhere on the board
unnamed: QP2.P$2 (G), QP3.P$1 (D), QP5.P$2 (G), QP6.P$2 (G), RGS10.1
unnamed: QN2.P$1 (D), QP3.P$2 (G), RGS2.2
OUTA_H: QN1.P$1 (D), R_ILIM2.2, R_ILIM3.2

Notes on the sheet:
NOTE: This will kill the 12V supply to the drivers so we can have QN1 pull very hard to ground without overheating.
NOTE: Will pull VDRV to GND

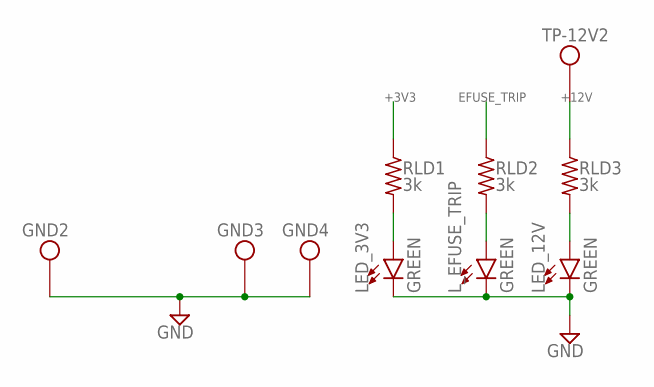
[picture p30: schematic EFUSE 2.0.0.sch, sheet 6, LED INDICATORS & TEST POINTS]

Parts:
GND2, GND3, GND4: THM_TESTPOINT_5000_SERIES; THM-TESTPOINT
LED_3V3, LED_12V: GREEN; LED-1206; LCSC_PART C434439
L_EFUSE_TRIP: GREEN; LED-1206; LCSC_PART C434439
RLD1, RLD2, RLD3: 3k; R0603; LCSC_PART C126358
TP-12V2: THM_TESTPOINT_5000_SERIES; THM-TESTPOINT

Connections:
+3V3: RLD1.1; also elsewhere on the board
+12V: RLD3.1, TP-12V2.P1; also elsewhere on the board
EFUSE_TRIP: RLD2.1; also elsewhere on the board
GND: GND2.P1, GND3.P1, GND4.P1, LED_3V3.C, LED_12V.C, L_EFUSE_TRIP.C; also elsewhere on the board
unnamed: LED_3V3.A, RLD1.2
unnamed: L_EFUSE_TRIP.A, RLD2.2
unnamed: LED_12V.A, RLD3.2

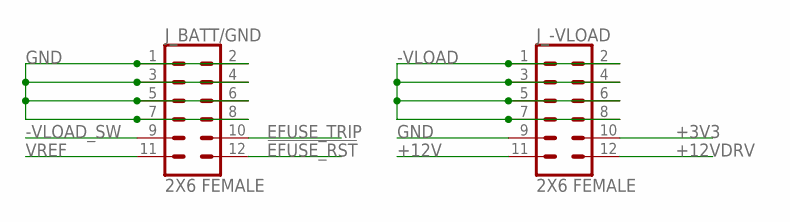
[picture p31: schematic EFUSE 2.0.0.sch, sheet 7, BOARD TO BOARD CONNECTORS]

Parts:
J_-VLOAD: 2X6 FEMALE; 2X6; LCSC_PART DNP
J_BATT/GND: 2X6 FEMALE; 2X6; LCSC_PART DNP

Connections:
!EFUSE_RST: J_BATT/GND.12; also elsewhere on the board
+3V3: J_-VLOAD.10; also elsewhere on the board
+12V: J_-VLOAD.11; also elsewhere on the board
+12VDRV: J_-VLOAD.12; also elsewhere on the board
-VLOAD: J_-VLOAD.1, J_-VLOAD.2, J_-VLOAD.3, J_-VLOAD.4, J_-VLOAD.5, J_-VLOAD.6, J_-VLOAD.7, J_-VLOAD.8; also elsewhere on the board
-VLOAD_SW: J_BATT/GND.9; also elsewhere on the board
EFUSE_TRIP: J_BATT/GND.10; also elsewhere on the board
GND: J_-VLOAD.9, J_BATT/GND.1, J_BATT/GND.2, J_BATT/GND.3, J_BATT/GND.4, J_BATT/GND.5, J_BATT/GND.6, J_BATT/GND.7, J_BATT/GND.8; also elsewhere on the board
VREF: J_BATT/GND.11; also elsewhere on the board

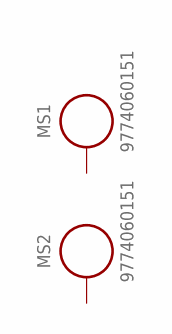
[picture p32: schematic EFUSE 2.0.0.sch, sheet 8, MECHANICAL]

Parts:
MS1, MS2: 9774060151; WA-SMSI_9774060151; LCSC_PART DNP

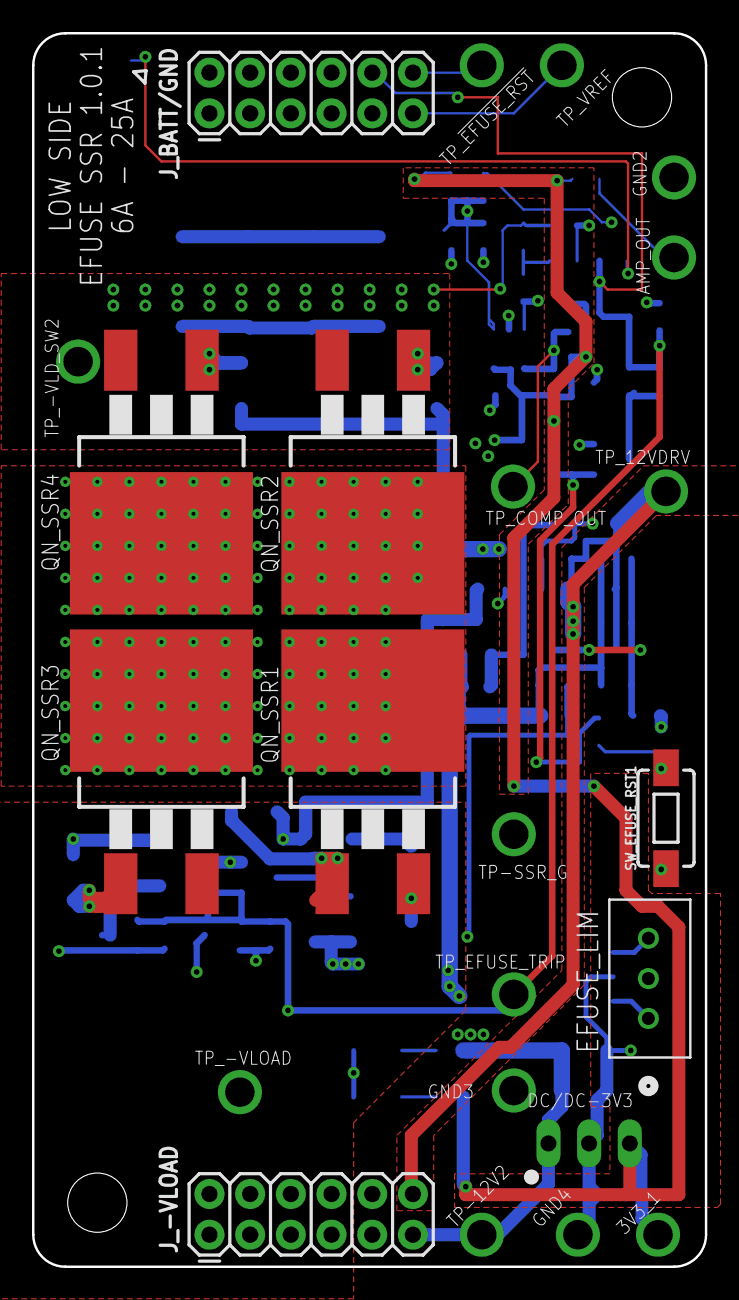
[picture p33: board EFUSE 2.0.0.brd from above]

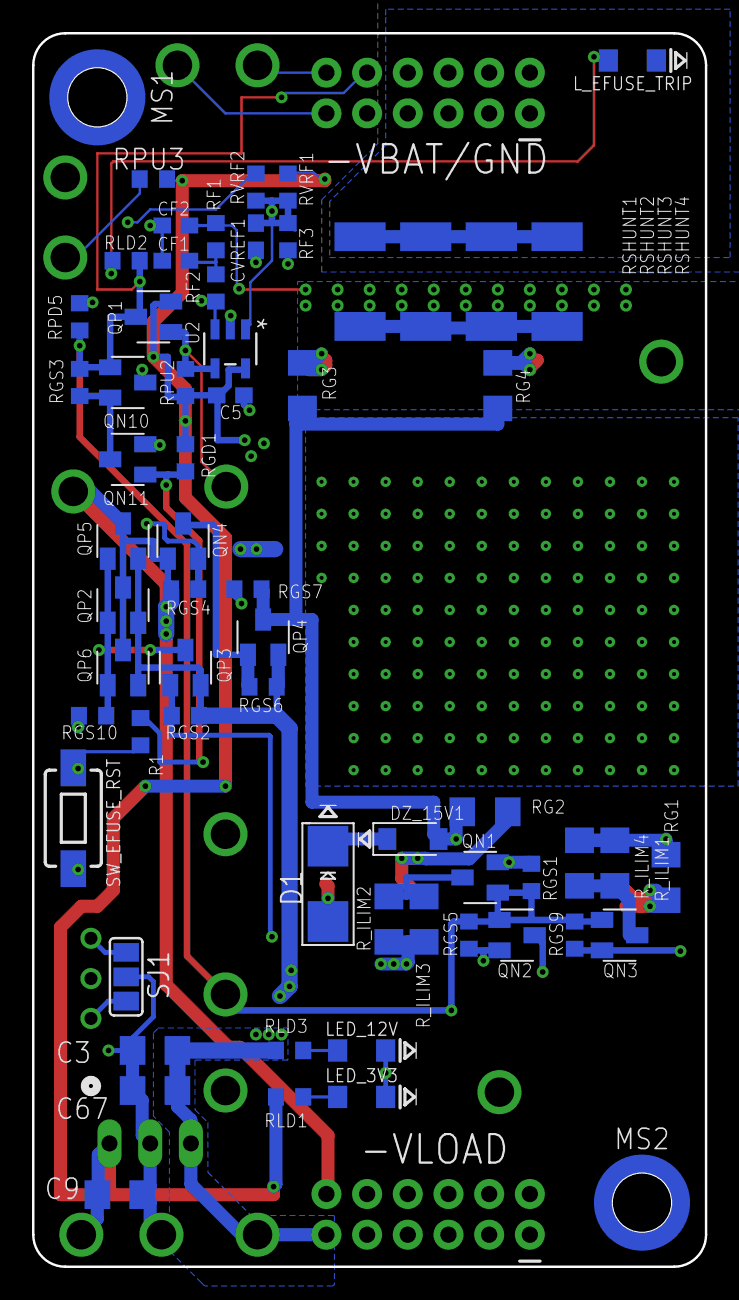
[picture p34: board EFUSE 2.0.0.brd from below]

Board: 4 copper layers, 42.0 x 77.0 mm, 86 parts (63 on the bottom side), 33 nets.
