gigaj0ule/safebridge/(notices)

Notices in the files:
parts and their libraries:
KVRLABS-Amplifiers: COPYRIGHT: Copyright (C) 2021 Ultra Librarian. All rights reserved.
SparkFun-LED: Licensing: Creative Commons ShareAlike 4.0 International - https://creativecommons.org/licenses/by-sa/4.0
Eagle_WA-SMSI: Copyright: Würth Elektronik
